MarcosARPMIND/Charger_Power_BOARD_V_0_7_0/PCB/Charger_Power_BOARD_V_0_7_0.kicad_pcb

## KiCad design PCB/Charger_Power_BOARD_V_0_7_0.kicad_pcb (2026-11-06)

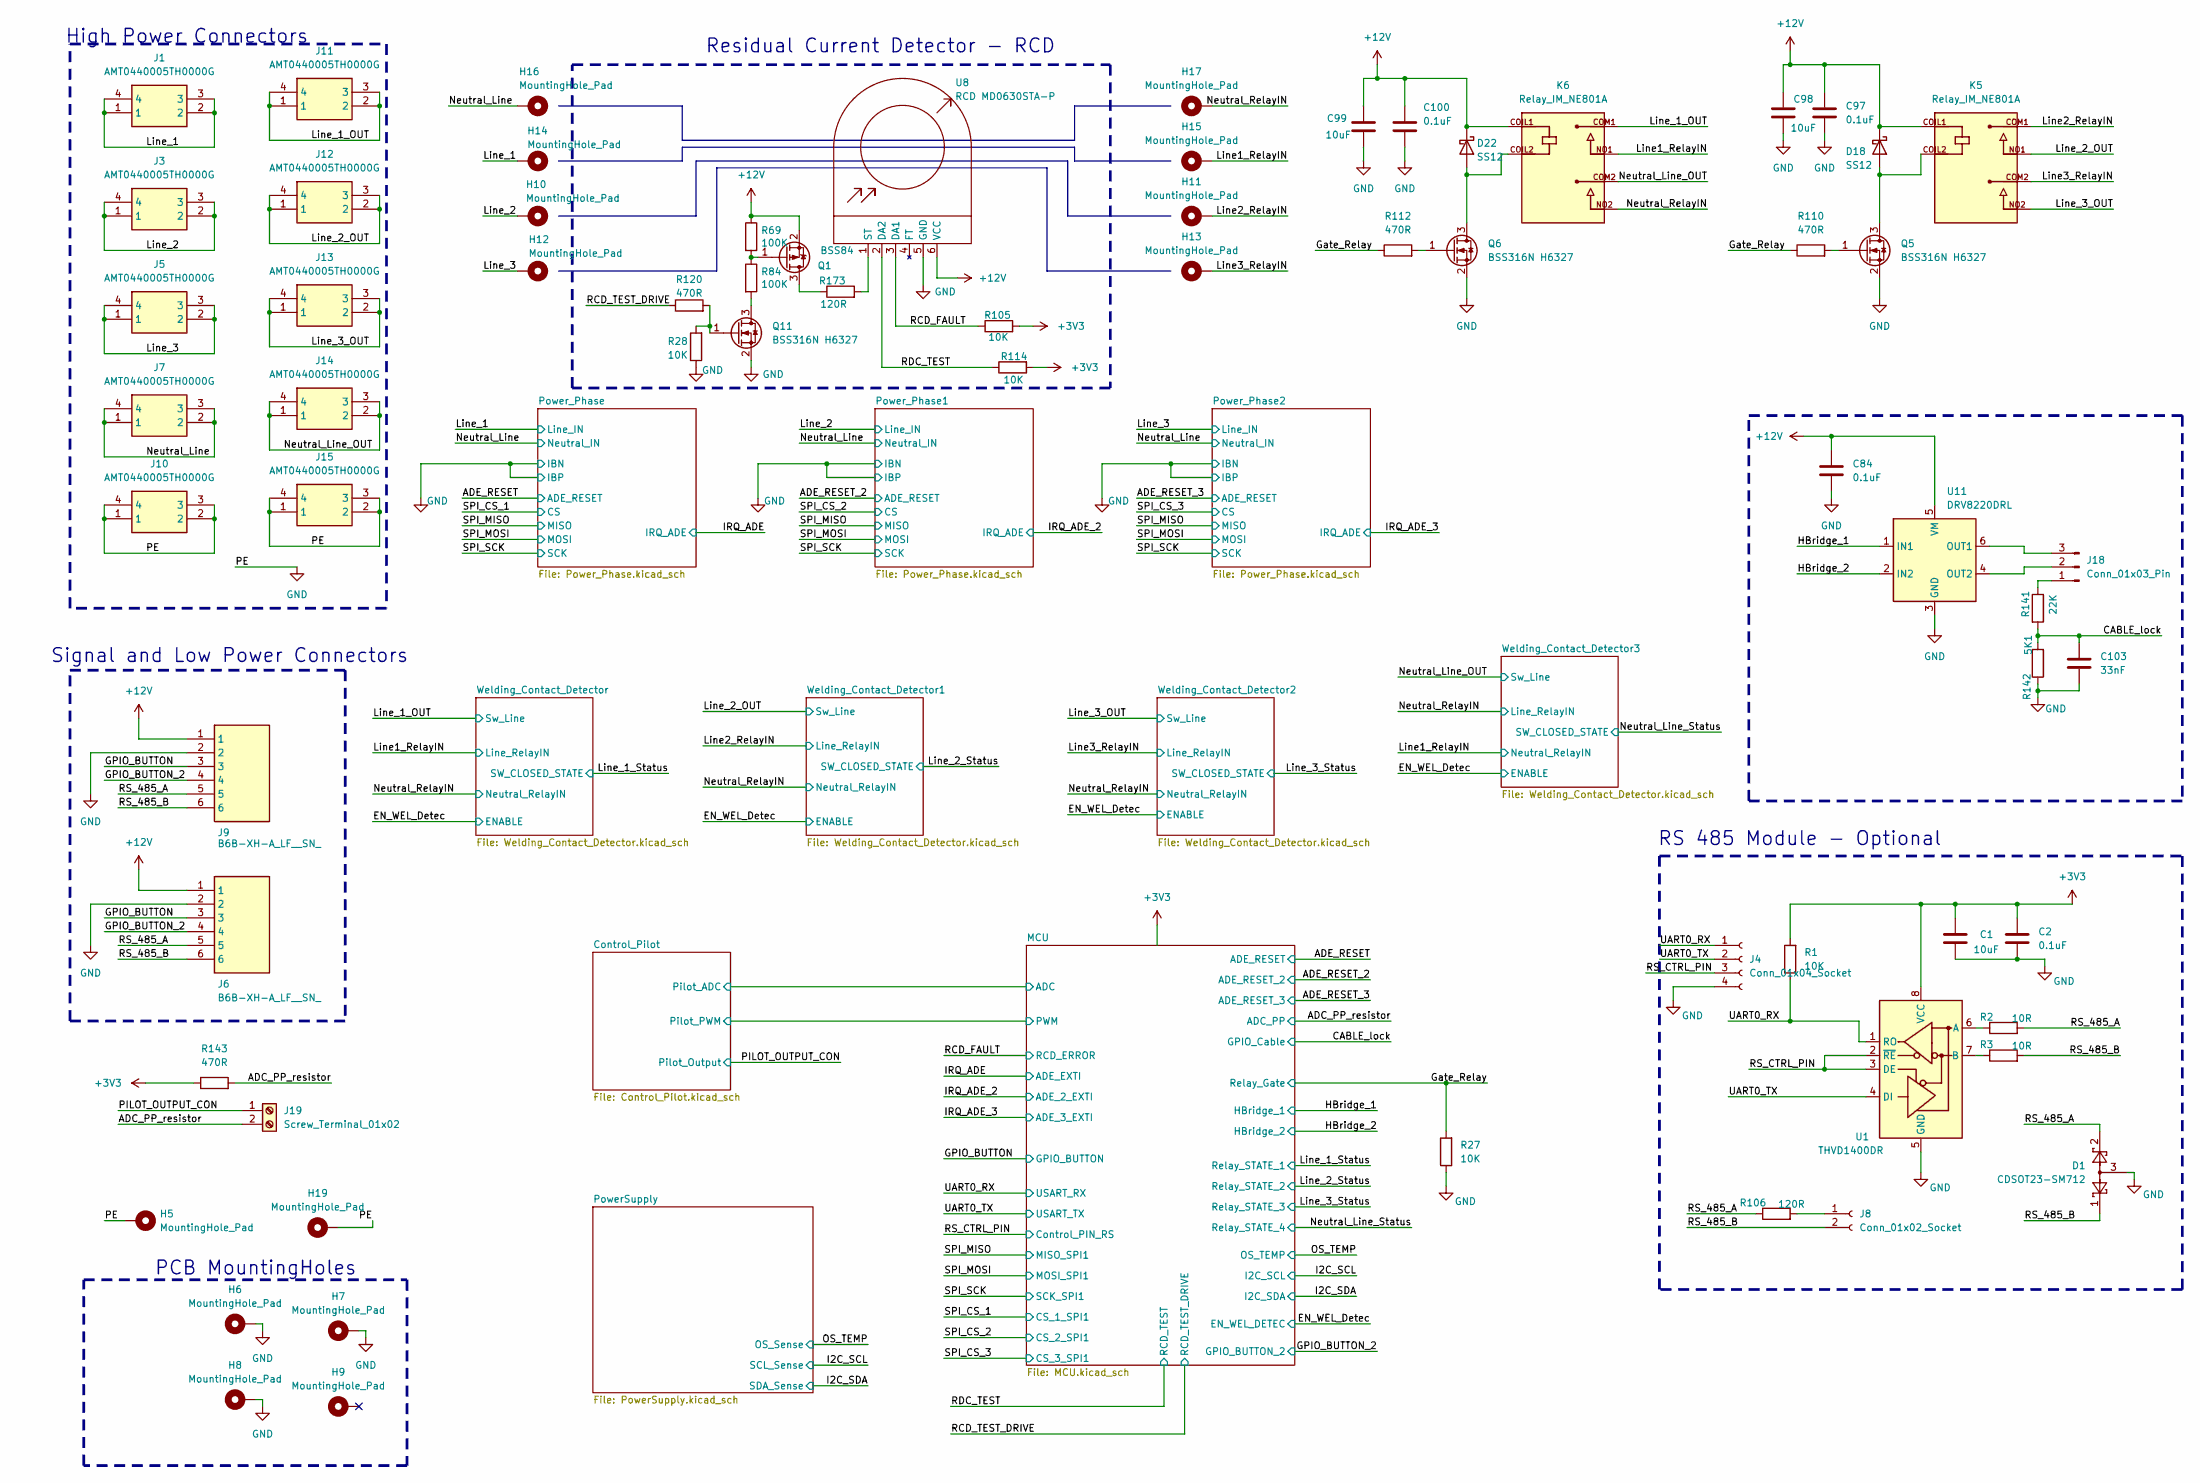
[picture p1: schematic Charger_Power_BOARD_V_0_7_0.kicad_sch]

Parts:
C1: 10uF; C_1206_3216Metric; MPN GMK316AB7106KL-TR
C2, C84, C97, C100: 0.1uF; C_0603_1608Metric; MPN CL10B104MB8NNNC
C98, C99: 10uF; C_1206_3216Metric
C103: 33nF; C_0603_1608Metric
D1: CDSOT23-SM712; SOT-23-3; MPN CDSOT23-SM712
D18, D22: SS12; D_SMA; MPN SS12-E3/61T
H5, H10, H11, H12, H13, H14, H15, H16, H17, H19: MountingHole_Pad; MountingHole_3.2mm_M3_DIN965_Pad_TopBottom
H6, H7, H8: MountingHole_Pad; MountingHole_5.3mm_M5_DIN965_Pad_TopBottom
H9: MountingHole_Pad; MountingHole_5.3mm_M5
J1, J3, J5, J7, J10, J11, J12, J13, J14, J15: AMT0440005TH0000G
J4: Conn_01x04_Socket; PinHeader_1x04_P2.54mm_Vertical
J6, J9: B6B-XH-A_LF__SN_; SHDR6W64P0X250_1X6_1740X575X700P
J8: Conn_01x02_Socket; PinHeader_1x02_P2.54mm_Vertical
J18: Conn_01x03_Pin; JST_VH_B3P-VH-FB-B_1x03_P3.96mm_Vertical
J19: Screw_Terminal_01x02; TerminalBlock_Phoenix_MKDS-3-2-5.08_1x02_P5.08mm_Horizontal
K5, K6: Relay_IM_NE801A
Q1: BSS84; SOT-23
Q5, Q6, Q11: BSS316N H6327; SOT-23; MPN BSS316N H6327
R1, R27, R28, R105, R114: 10K; R_0603_1608Metric; MPN RCS060310K0FKEA
R2, R3: 10R; R_0603_1608Metric; MPN 0603WAF100JT1E
R69, R84: 100K; R_0603_1608Metric
R106: 120R; R_0603_1608Metric; MPN CRCW0603120RFKEAC
R110, R112, R120, R143: 470R; R_0603_1608Metric
R141: 22K; R_0603_1608Metric
R142: 5K1; R_0603_1608Metric
R173: 120R; R_0603_1608Metric; MPN RE0603FRE07150RL
U1: THVD1400DR; SOIC127P600X175-8N
U8: RCD MD0630STA-P; RCD_MD0630STA_P
U11: DRV8220DRL; SOT-563

Connections:
+3V3: C1.2, C2.1, R1.2, R105.2, R114.2, R143.1, U1.8 (VCC); also elsewhere on the board
+12V: C84.1, C97.1, C98.1, C99.1, C100.1, D18.1 (K), D22.1 (K), J6.1, J9.1, K5.COIL1, K6.COIL1, Q1.2 (S), R69.1, U8.6 (VCC), U11.5 (VM); also elsewhere on the board
/ADC_PP_resistor: J19.2, R143.2; also elsewhere on the board
/CABLE_lock: C103.1, R141.2, R142.2; also elsewhere on the board
/GPIO_BUTTON: J6.3, J9.3; also elsewhere on the board
/GPIO_BUTTON_2: J6.4, J9.4; also elsewhere on the board
/Gate_Relay: R27.2, R110.1, R112.1; also elsewhere on the board
/HBridge_1: U11.1 (IN1); also elsewhere on the board
/HBridge_2: U11.2 (IN2); also elsewhere on the board
/Line1_RelayIN: H15.1 (1_1), K6.NO1; also elsewhere on the board
/Line2_RelayIN: H11.1 (1_1), K5.COM1; also elsewhere on the board
/Line3_RelayIN: H13.1 (1_1), K5.COM2; also elsewhere on the board
/Line_1: H14.1 (1_1), J1.1, J1.2, J1.3, J1.4; also elsewhere on the board
/Line_1_OUT: J11.1, J11.2, J11.3, J11.4, K6.COM1; also elsewhere on the board
/Line_2: H10.1 (1_1), J3.1, J3.2, J3.3, J3.4; also elsewhere on the board
/Line_2_OUT: J12.1, J12.2, J12.3, J12.4, K5.NO1; also elsewhere on the board
/Line_3: H12.1 (1_1), J5.1, J5.2, J5.3, J5.4; also elsewhere on the board
/Line_3_OUT: J13.1, J13.2, J13.3, J13.4, K5.NO2; also elsewhere on the board
/Neutral_Line: H16.1 (1_1), J7.1, J7.2, J7.3, J7.4; also elsewhere on the board
/Neutral_Line_OUT: J14.1, J14.2, J14.3, J14.4, K6.COM2; also elsewhere on the board
/Neutral_RelayIN: H17.1 (1_1), K6.NO2; also elsewhere on the board
/PILOT_OUTPUT_CON: J19.1; also elsewhere on the board
/RCD_FAULT: R105.1, U8.3 (DA1); also elsewhere on the board
/RCD_TEST_DRIVE: R120.1; also elsewhere on the board
/RDC_TEST: R114.1, U8.2 (DA2); also elsewhere on the board
/RS_485_A: D1.2, J6.5, J9.5, R2.2, R106.1
/RS_485_B: D1.1, J6.6, J8.2, J9.6, R3.2
/RS_CTRL_PIN: J4.3, U1.2 (~RE), U1.3 (DE); also elsewhere on the board
/UART0_RX: J4.1, R1.1, U1.1 (RO); also elsewhere on the board
/UART0_TX: J4.2, U1.4 (DI); also elsewhere on the board
GND: C1.1, C2.2, C84.2, C97.2, C98.2, C99.2, C100.2, C103.2, D1.3, H5.1 (1_1), H6.1 (1_1), H7.1 (1_1), H8.1 (1_1), H19.1 (1_1), J4.4, J6.2, J9.2, J10.1, J10.2, J10.3, J10.4, J15.1, J15.2, J15.3, J15.4, Q5.2 (S), Q6.2 (S), Q11.2 (S), R27.1, R28.1, R142.1, U1.5 (GND), U8.5 (GND), U11.3 (GND); also elsewhere on the board
unnamed: D18.2 (A), K5.COIL2, Q5.3 (D)
unnamed: D22.2 (A), K6.COIL2, Q6.3 (D)
unnamed: J8.1, R106.2
unnamed: J18.1, R141.1
unnamed: J18.2, U11.4 (OUT2)
unnamed: J18.3, U11.6 (OUT1)
unnamed: Q1.3 (D), R173.1
unnamed: Q1.1 (G), R69.2, R84.1
unnamed: Q5.1 (G), R110.2
unnamed: Q6.1 (G), R112.2
unnamed: Q11.3 (D), R84.2
unnamed: Q11.1 (G), R28.2, R120.2
unnamed: R2.1, U1.6 (A)
unnamed: R3.1, U1.7 (B)
unnamed: R173.2, U8.1 (ST)

Notes on the sheet:
PCB MountingHoles
Residual Current Detector - RCD
RS 485 Module - Optional
Signal and Low Power Connectors
High Power Connectors

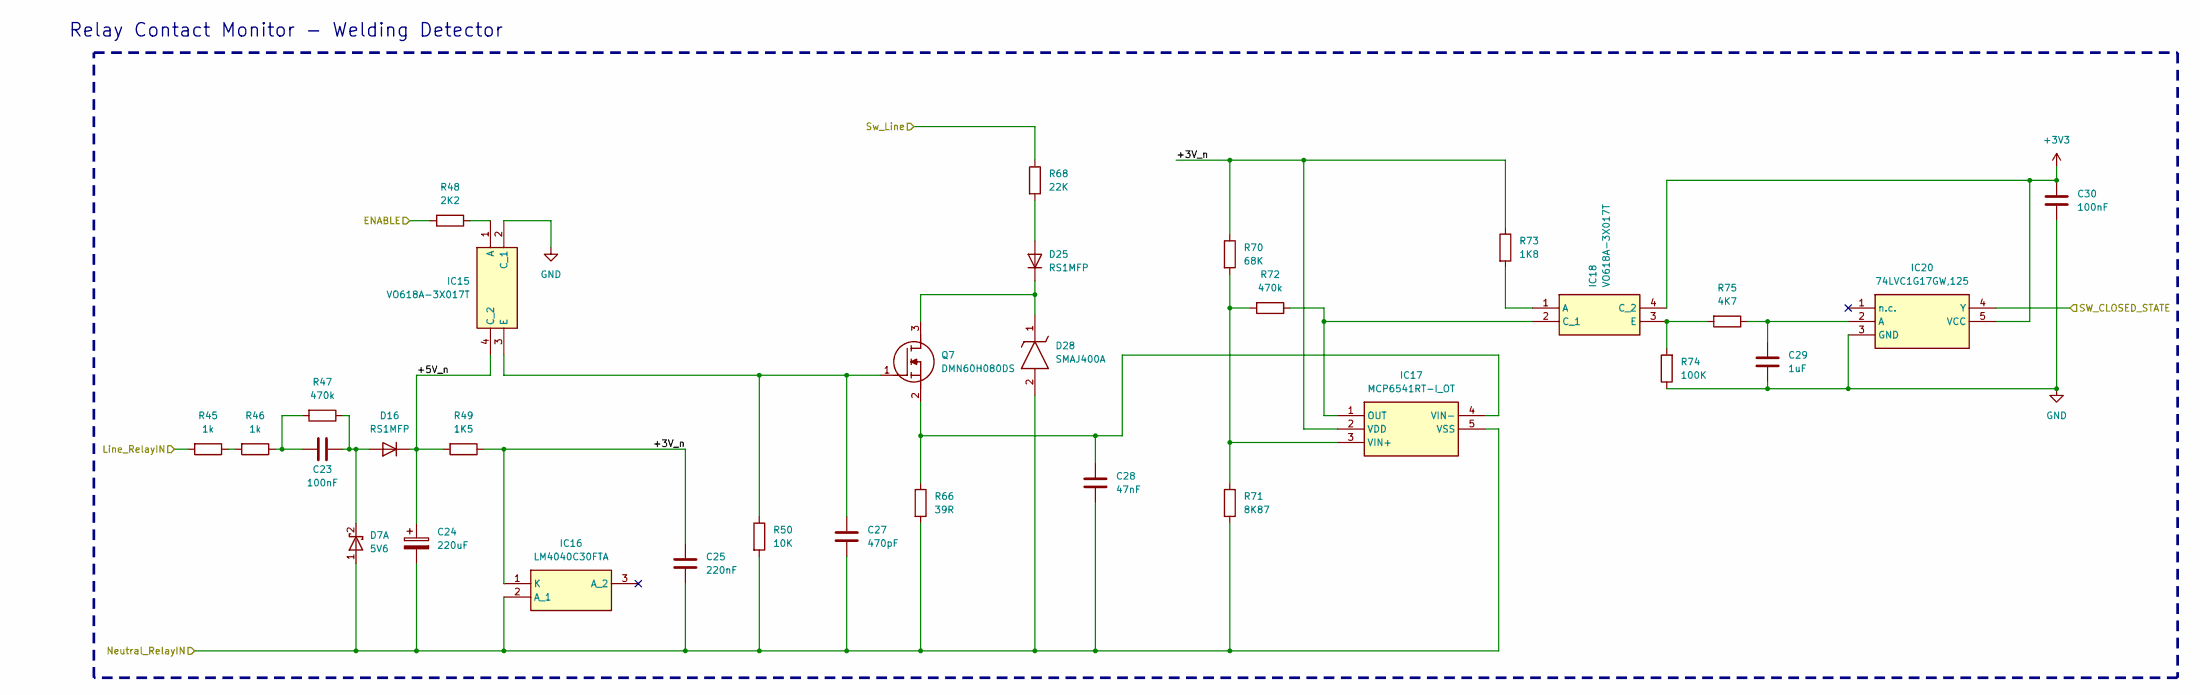
[picture p2: schematic Welding_Contact_Detector.kicad_sch]

Parts:
C23: 100nF; C_Rect_L18.0mm_W5.0mm_P15.00mm_FKS3_FKP3
C24: 220uF; CP_Radial_D8.0mm_P3.50mm
C25: 220nF; C_0603_1608Metric
C27: 470pF; C_0603_1608Metric
C28: 47nF; C_0603_1608Metric
C29: 1uF; C_0603_1608Metric
C30: 100nF; C_0603_1608Metric
D7: 5V6; D_SOD-123
D16, D25: RS1MFP; D_SOD-123
D28: SMAJ400A; DIOM5026X229N
IC15, IC18: VO618A-3X017T; SMD-4_OPTION_7
IC16: LM4040C30FTA; SOT-23-3
IC17: MCP6541RT-I_OT; SOT95P280X145-5N
IC20: 74LVC1G17GW,125; SOT65P212X110-5N
Q7: DMN60H080DS; SOT-23-3
R45, R46: 1k; R_1206_3216Metric
R47: 470k; R_1206_3216Metric
R48: 2K2; R_0603_1608Metric
R49: 1K5; R_0603_1608Metric
R50: 10K; R_0603_1608Metric
R66: 39R; R_0603_1608Metric
R68: 22K; R_Axial_DIN0411_L9.9mm_D3.6mm_P12.70mm_Horizontal
R70: 68K; R_0603_1608Metric
R71: 8K87; R_0603_1608Metric
R72: 470k; R_0603_1608Metric
R73: 1K8; R_0603_1608Metric
R74: 100K; R_0603_1608Metric
R75: 4K7; R_0603_1608Metric

Connections:
+3V3: C30.1, IC18.4 (C_2), IC20.5 (VCC); also elsewhere on the board
/EN_WEL_Detec: R48.2; also elsewhere on the board
/Line2_RelayIN: R45.2; also elsewhere on the board
/Line_2_OUT: R68.1; also elsewhere on the board
/Line_2_Status: IC20.4 (Y); also elsewhere on the board
/Neutral_RelayIN: C24.2, C25.2, C27.2, C28.2, D7.1 (A), D28.2 (A), IC16.2 (A_1), IC17.5 (VSS), R50.2, R66.2, R71.2; also elsewhere on the board
/Welding_Contact_Detector1/+3V_n: C25.1, IC16.1 (K), IC17.2 (VDD), R49.1, R70.1, R73.1
/Welding_Contact_Detector1/+5V_n: C24.1, D16.1 (K), IC15.4 (C_2), R49.2
GND: C29.2, C30.2, IC15.2 (C_1), IC20.3 (GND), R74.1; also elsewhere on the board
unnamed: C23.2, R46.1, R47.2
unnamed: C23.1, D7.2 (K), D16.2 (A), R47.1
unnamed: D25.2 (A), R68.2
unnamed: D25.1 (K), D28.1 (K), Q7.3 (D)
unnamed: IC15.1 (A), R48.1
unnamed: C27.1, IC15.3 (E), Q7.1 (G), R50.1
unnamed: IC17.1 (OUT), IC18.2 (C_1), R72.1
unnamed: IC17.3 (VIN+), R70.2, R71.1, R72.2
unnamed: C28.1, IC17.4 (VIN-), Q7.2 (S), R66.1
unnamed: IC18.1 (A), R73.2
unnamed: IC18.3 (E), R74.2, R75.2
unnamed: C29.1, IC20.2 (A), R75.1
unnamed: R45.1, R46.2

Parts of its further copies:
C26, C37, C61: 100nF; C_Rect_L18.0mm_W5.0mm_P15.00mm_FKS3_FKP3
C31, C38, C62: 220uF; CP_Radial_D8.0mm_P3.50mm
C32, C39, C63: 220nF; C_0603_1608Metric
C33, C40, C64: 470pF; C_0603_1608Metric
C34, C58, C65: 47nF; C_0603_1608Metric
C35, C59, C66: 1uF; C_0603_1608Metric
C36, C60, C67: 100nF; C_0603_1608Metric
D29, D49, D53: 5V6; D_SOD-123
D30, D31, D50, D51, D54, D55: RS1MFP; D_SOD-123
D48, D52, D56: SMAJ400A; DIOM5026X229N
IC21, IC24, IC26, IC46, IC48, IC51: VO618A-3X017T; SMD-4_OPTION_7
IC22, IC27, IC49: LM4040C30FTA; SOT-23-3
IC23, IC45, IC50: MCP6541RT-I_OT; SOT95P280X145-5N
IC25, IC47, IC52: 74LVC1G17GW,125; SOT65P212X110-5N
Q8, Q9, Q10: DMN60H080DS; SOT-23-3
R76, R77, R91, R92, R127, R128: 1k; R_1206_3216Metric
R78, R93, R129: 470k; R_1206_3216Metric
R79, R115, R130: 2K2; R_0603_1608Metric
R80, R116, R131: 1K5; R_0603_1608Metric
R81, R117, R132: 10K; R_0603_1608Metric
R82, R118, R133: 39R; R_0603_1608Metric
R83, R119, R134: 22K; R_Axial_DIN0411_L9.9mm_D3.6mm_P12.70mm_Horizontal
R85, R121, R136: 68K; R_0603_1608Metric
R86, R122, R137: 8K87; R_0603_1608Metric
R87, R123, R138: 470k; R_0603_1608Metric
R88, R124, R139: 1K8; R_0603_1608Metric
R89, R125, R140: 100K; R_0603_1608Metric
R90, R126, R215: 4K7; R_0603_1608Metric

Connections of its further copies:
+3V3: C36.1, C60.1, C67.1, IC24.4 (C_2), IC25.5 (VCC), IC46.4 (C_2), IC47.5 (VCC), IC51.4 (C_2), IC52.5 (VCC); also elsewhere on the board
/EN_WEL_Detec: R79.2, R115.2, R130.2; also elsewhere on the board
/Line1_RelayIN: C62.2, C63.2, C64.2, C65.2, D53.1 (A), D56.2 (A), IC49.2 (A_1), IC50.5 (VSS), R91.2, R132.2, R133.2, R137.2; also elsewhere on the board
/Line3_RelayIN: R76.2; also elsewhere on the board
/Line_1_OUT: R119.1; also elsewhere on the board
/Line_1_Status: IC47.4 (Y); also elsewhere on the board
/Line_3_OUT: R83.1; also elsewhere on the board
/Line_3_Status: IC25.4 (Y); also elsewhere on the board
/Neutral_Line_OUT: R134.1; also elsewhere on the board
/Neutral_Line_Status: IC52.4 (Y); also elsewhere on the board
/Neutral_RelayIN: C31.2, C32.2, C33.2, C34.2, C38.2, C39.2, C40.2, C58.2, D29.1 (A), D48.2 (A), D49.1 (A), D52.2 (A), IC22.2 (A_1), IC23.5 (VSS), IC27.2 (A_1), IC45.5 (VSS), R81.2, R82.2, R86.2, R117.2, R118.2, R122.2, R127.2; also elsewhere on the board
/Welding_Contact_Detector2/+3V_n: C32.1, IC22.1 (K), IC23.2 (VDD), R80.1, R85.1, R88.1
/Welding_Contact_Detector2/+5V_n: C31.1, D30.1 (K), IC21.4 (C_2), R80.2
/Welding_Contact_Detector3/+3V_n: C63.1, IC49.1 (K), IC50.2 (VDD), R131.1, R136.1, R139.1
/Welding_Contact_Detector3/+5V_n: C62.1, D54.1 (K), IC48.4 (C_2), R131.2
/Welding_Contact_Detector/+3V_n: C39.1, IC27.1 (K), IC45.2 (VDD), R116.1, R121.1, R124.1
/Welding_Contact_Detector/+5V_n: C38.1, D50.1 (K), IC26.4 (C_2), R116.2
GND: C35.2, C36.2, C59.2, C60.2, C66.2, C67.2, IC21.2 (C_1), IC25.3 (GND), IC26.2 (C_1), IC47.3 (GND), IC48.2 (C_1), IC52.3 (GND), R89.1, R125.1, R140.1; also elsewhere on the board
unnamed: C26.2, R77.1, R78.2
unnamed: C37.2, R92.1, R93.2
unnamed: C61.2, R128.1, R129.2
unnamed: C26.1, D29.2 (K), D30.2 (A), R78.1
unnamed: D31.2 (A), R83.2
unnamed: D31.1 (K), D48.1 (K), Q8.3 (D)
unnamed: C37.1, D49.2 (K), D50.2 (A), R93.1
unnamed: D51.2 (A), R119.2
unnamed: D51.1 (K), D52.1 (K), Q9.3 (D)
unnamed: C61.1, D53.2 (K), D54.2 (A), R129.1
unnamed: D55.2 (A), R134.2
unnamed: D55.1 (K), D56.1 (K), Q10.3 (D)
unnamed: IC21.1 (A), R79.1
unnamed: C33.1, IC21.3 (E), Q8.1 (G), R81.1
unnamed: IC23.1 (OUT), IC24.2 (C_1), R87.1
unnamed: IC23.3 (VIN+), R85.2, R86.1, R87.2
unnamed: C34.1, IC23.4 (VIN-), Q8.2 (S), R82.1
unnamed: IC24.1 (A), R88.2
unnamed: IC24.3 (E), R89.2, R90.2
unnamed: C35.1, IC25.2 (A), R90.1
unnamed: IC26.1 (A), R115.1
unnamed: C40.1, IC26.3 (E), Q9.1 (G), R117.1
unnamed: IC45.1 (OUT), IC46.2 (C_1), R123.1
unnamed: IC45.3 (VIN+), R121.2, R122.1, R123.2
unnamed: C58.1, IC45.4 (VIN-), Q9.2 (S), R118.1
unnamed: IC46.1 (A), R124.2
unnamed: IC46.3 (E), R125.2, R126.2
unnamed: C59.1, IC47.2 (A), R126.1
unnamed: IC48.1 (A), R130.1
unnamed: C64.1, IC48.3 (E), Q10.1 (G), R132.1
unnamed: IC50.1 (OUT), IC51.2 (C_1), R138.1
unnamed: IC50.3 (VIN+), R136.2, R137.1, R138.2
unnamed: C65.1, IC50.4 (VIN-), Q10.2 (S), R133.1
unnamed: IC51.1 (A), R139.2
unnamed: IC51.3 (E), R140.2, R215.2
unnamed: C66.1, IC52.2 (A), R215.1
unnamed: R76.1, R77.2
unnamed: R91.1, R92.2
unnamed: R127.1, R128.2

Notes on the sheet:
Relay Contact Monitor - Welding Detector

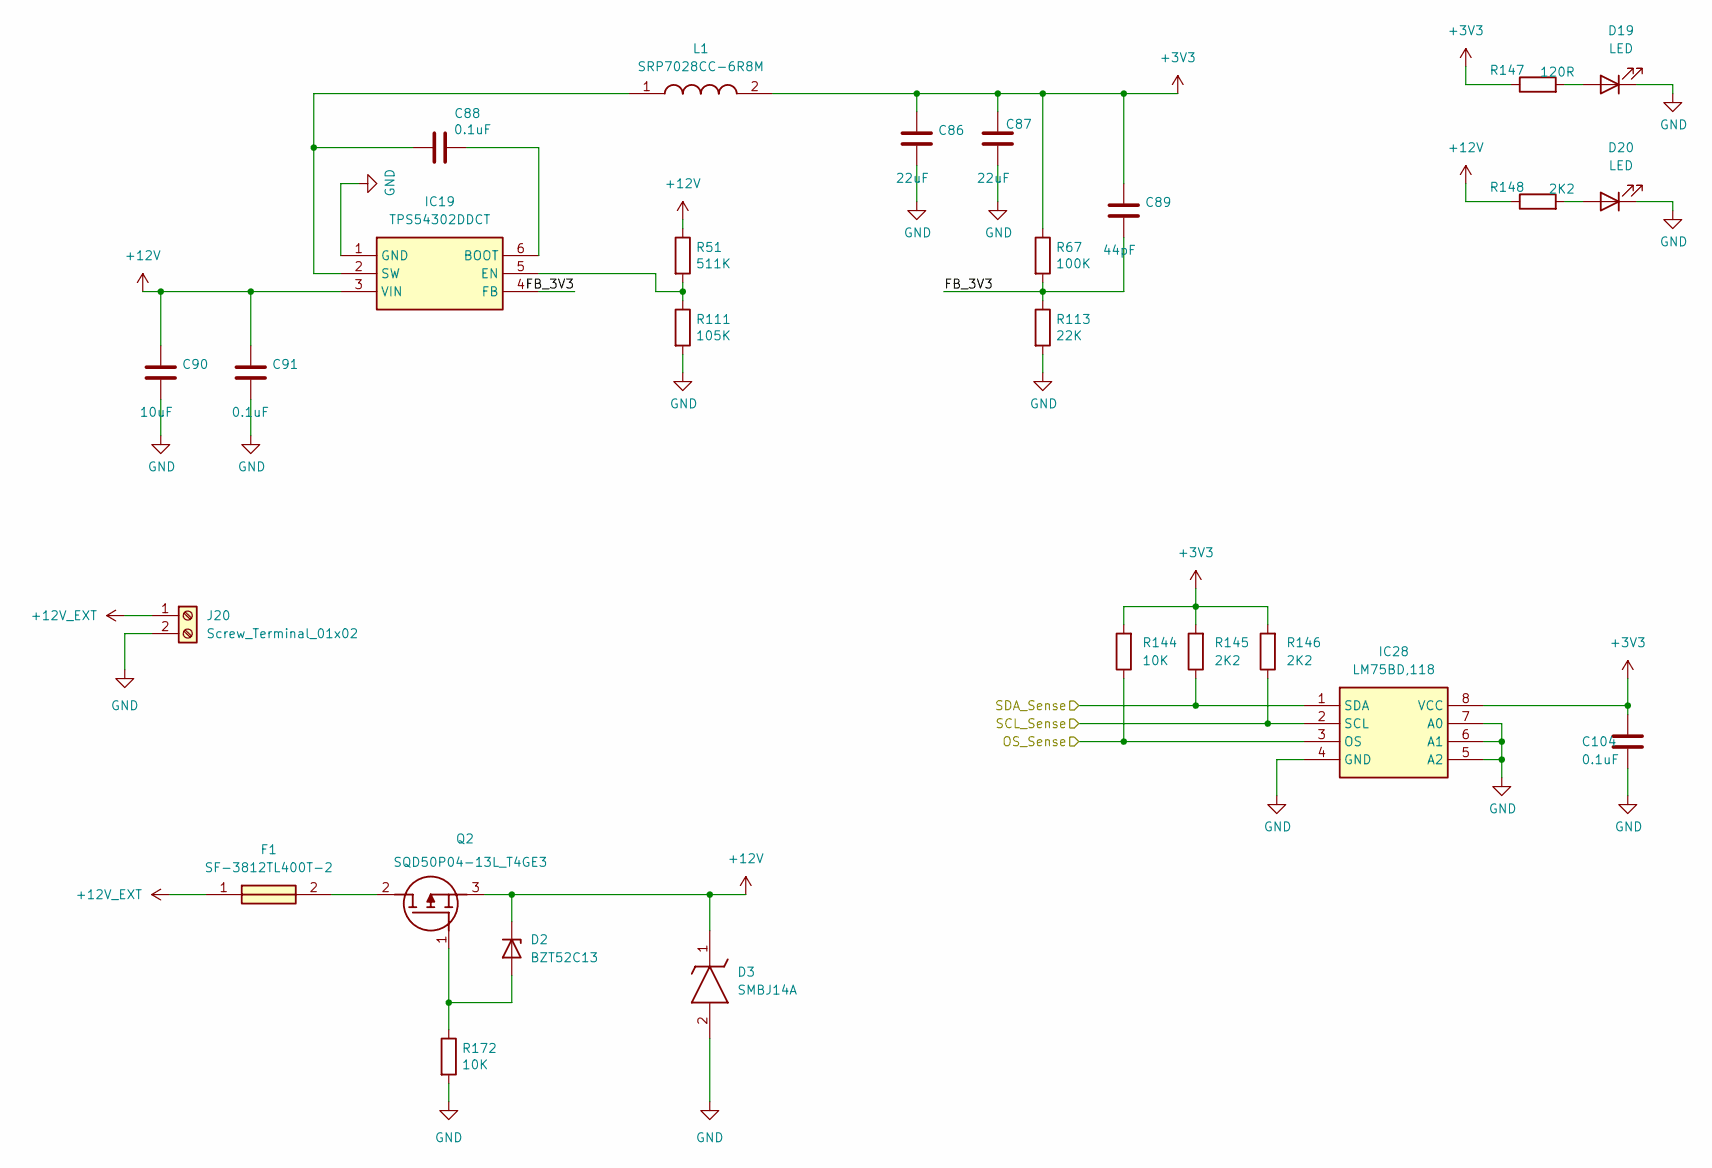
[picture p3: schematic PowerSupply.kicad_sch]

Parts:
C86, C87: 22uF; C_1206_3216Metric
C88, C91: 0.1uF; C_0603_1608Metric
C89: 44pF; C_0603_1608Metric
C90: 10uF; C_1206_3216Metric
C104: 0.1uF; C_0603_1608Metric; MPN CL10B104MB8NNNC
D2: BZT52C13; D_SOD-123
D3: SMBJ14A; DIOM5436X261N; Manufacturer_Part_Number SMBJ14A
D19, D20: LED; LED_0603_1608Metric
F1: SF-3812TL400T-2; SF3812TL400T2; Mouser Part Number 652-SF-3812TL400T-2
IC19: TPS54302DDCT; SOT95P280X110-6N
IC28: LM75BD,118; SOIC127P600X175-8N
J20: Screw_Terminal_01x02; TerminalBlock_Phoenix_MKDS-3-2-5.08_1x02_P5.08mm_Horizontal
L1: SRP7028CC-6R8M; INDPM7366X300N
Q2: SQD50P04-13L_T4GE3; SQD50P0413L_T4GE3; Mouser Part Number 78-SQD50P04-13LT4GE3
R51: 511K; R_0603_1608Metric
R67: 100K; R_0603_1608Metric
R111: 105K; R_0603_1608Metric
R113: 22K; R_0603_1608Metric
R144, R172: 10K; R_0603_1608Metric; MPN RCS060310K0FKEA
R145, R146: 2K2; R_0603_1608Metric; MPN RCS060310K0FKEA
R147: 120R; R_0603_1608Metric; MPN CRCW0603120RFKEAC
R148: 2K2; R_0603_1608Metric; MPN AC0603FR-072K2L

Connections:
+3V3: C86.1, C87.1, C89.1, C104.1, IC28.8 (VCC), L1.2, R67.1, R144.2, R145.2, R146.2, R147.1; also elsewhere on the board
+12V: C90.1, C91.1, D2.1 (K), D3.1 (K), IC19.3 (VIN), Q2.3 (S), R51.1, R148.1; also elsewhere on the board
+12V_EXT: F1.1, J20.1
/I2C_SCL: IC28.2 (SCL), R146.1; also elsewhere on the board
/I2C_SDA: IC28.1 (SDA), R145.1; also elsewhere on the board
/OS_TEMP: IC28.3 (OS), R144.1; also elsewhere on the board
/PowerSupply/FB_3V3: C89.2, IC19.4 (FB), R67.2, R113.1
GND: C86.2, C87.2, C90.2, C91.2, C104.2, D3.2 (A), D19.1 (K), D20.1 (K), IC19.1 (GND), IC28.4 (GND), IC28.5 (A2), IC28.6 (A1), IC28.7 (A0), J20.2, R111.2, R113.2, R172.2; also elsewhere on the board
unnamed: D2.2 (A), Q2.1 (G), R172.1
unnamed: D19.2 (A), R147.2
unnamed: D20.2 (A), R148.2
unnamed: C88.2, IC19.6 (BOOT)
unnamed: IC19.5 (EN), R51.2, R111.1
unnamed: C88.1, IC19.2 (SW), L1.1
unnamed: F1.2, Q2.2 (D)

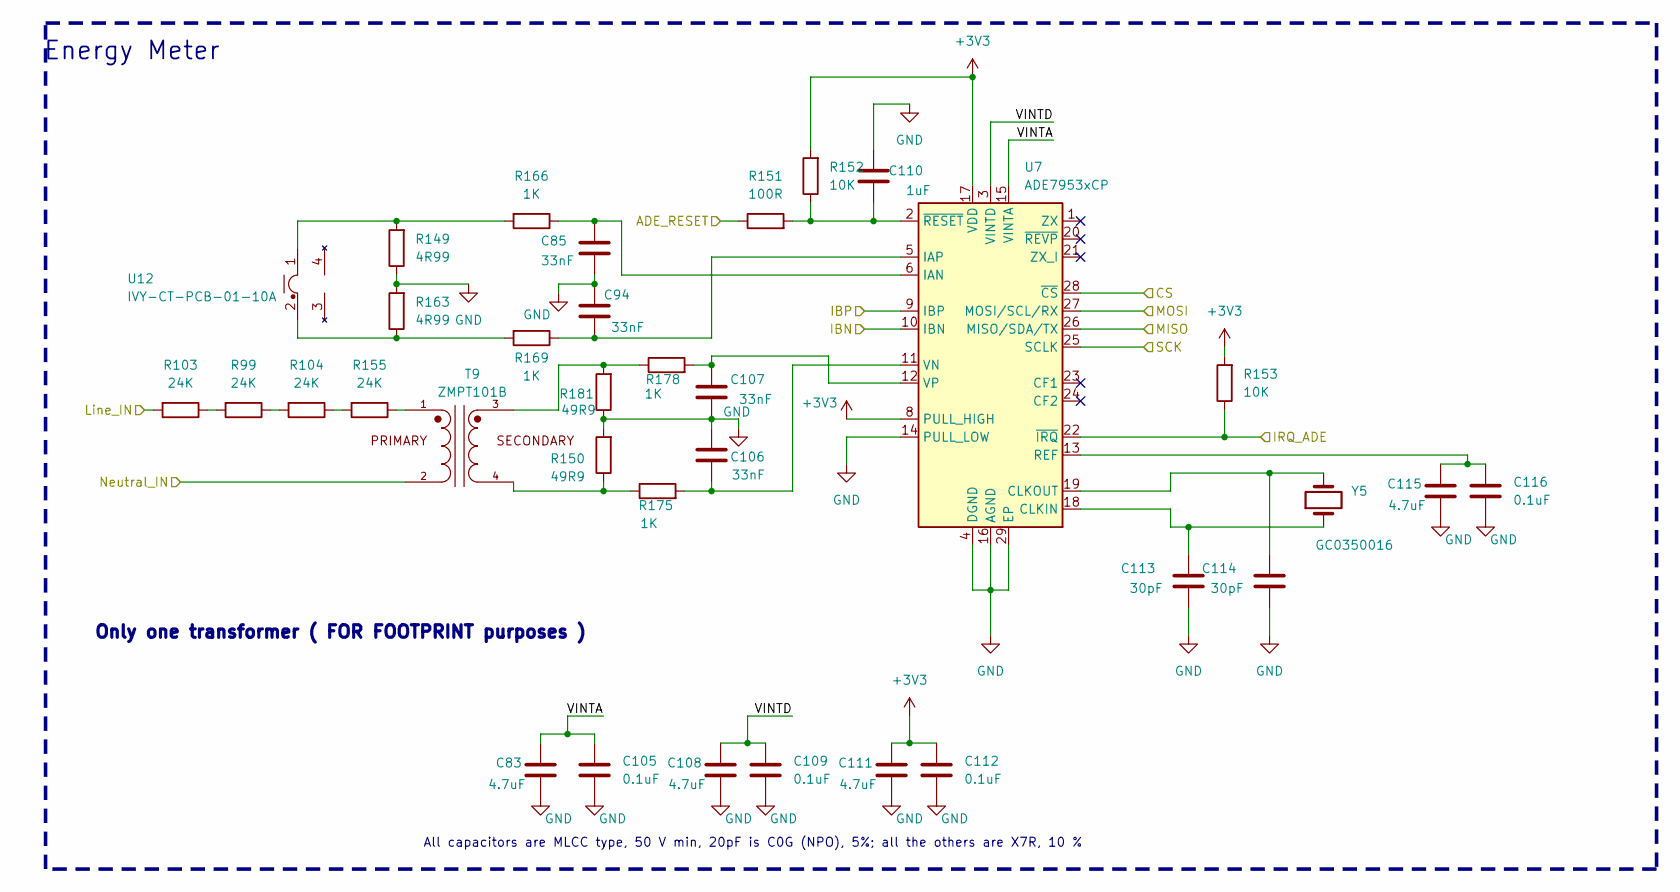
[picture p4: schematic Power_Phase.kicad_sch]

Parts:
C83, C108, C111, C115: 4.7uF; C_0805_2012Metric; MPN GRM21BZ7YA475ME15L
C85, C94, C106, C107: 33nF; C_0603_1608Metric_Pad1.08x0.95mm_HandSolder; MPN 0603B333J500CT
C105, C109, C112, C116: 0.1uF; C_0603_1608Metric; MPN CL10B104MB8NNNC
C110: 1uF; C_1206_3216Metric; MPN CL10B105KB8NQNC
C113, C114: 30pF; C_0603_1608Metric_Pad1.08x0.95mm_HandSolder; MPN CML0603C0G300JT50V
R99, R103, R104, R155: 24K; R_1206_3216Metric; MPN ESR18EZPF2402
R149, R163: 4R99; R_0603_1608Metric; MPN CRCW06034K99FKEAC
R150, R181: 49R9; R_0603_1608Metric; MPN CRCW0603100RJNEA
R151: 100R; R_0603_1608Metric; MPN CRCW0603100RJNEA
R152, R153: 10K; R_0603_1608Metric; MPN RCS060310K0FKEA
R166, R169, R175, R178: 1K; R_0603_1608Metric; MPN CRCW060336R0FKEA
T9: ZMPT101B; XFMR_ZMPT101B
U7: ADE7953xCP; LFCSP-28-1EP_5x5mm_P0.5mm_EP3.14x3.14mm_ThermalVias_MigCOM; MPN ADE7953ACPZ
U12: IVY-CT-PCB-01-10A; CT_IVY_01_10A
Y5: GC0350016; Crystal_SMD_HC49-SD; MPN GC0350016

Connections:
+3V3: C111.2, C112.1, R152.2, R153.2, U7.7 (PULL_HIGH), U7.8 (PULL_HIGH), U7.17 (VDD); also elsewhere on the board
/ADE_RESET_2: R151.1; also elsewhere on the board
/IRQ_ADE_2: R153.1, U7.22 (~IRQ); also elsewhere on the board
/Line_2: R103.2; also elsewhere on the board
/Neutral_Line: T9.2; also elsewhere on the board
/Power_Phase1/VINTA: C83.2, C105.1, U7.15 (VINTA)
/Power_Phase1/VINTD: C108.2, C109.1, U7.3 (VINTD)
/SPI_CS_2: U7.28 (~CS); also elsewhere on the board
/SPI_MISO: U7.26 (MISO/SDA/TX); also elsewhere on the board
/SPI_MOSI: U7.27 (MOSI/SCL/RX); also elsewhere on the board
/SPI_SCK: U7.25 (SCLK); also elsewhere on the board
GND: C83.1, C85.1, C94.2, C105.2, C106.2, C107.1, C108.1, C109.2, C110.2, C111.1, C112.2, C113.1, C114.1, C115.1, C116.2, R149.1, R150.2, R163.2, R181.1, U7.4 (DGND), U7.9 (IBP), U7.10 (IBN), U7.14 (PULL_LOW), U7.16 (AGND), U7.29 (EP); also elsewhere on the board
unnamed: R99.2, R103.1
unnamed: R104.1, R155.2
unnamed: R99.1, R104.2
unnamed: R149.2, R166.2, U12.1
unnamed: R150.1, R175.1, T9.4
unnamed: R155.1, T9.1
unnamed: R163.1, R169.2, U12.2
unnamed: R178.1, R181.2, T9.3
unnamed: C113.2, U7.18 (CLKIN), Y5.1
unnamed: C114.2, U7.19 (CLKOUT), Y5.2
unnamed: C85.2, R166.1, U7.6 (IAN)
unnamed: C94.1, R169.1, U7.5 (IAP)
unnamed: C115.2, C116.1, U7.13 (REF)
unnamed: C106.1, R175.2, U7.11 (VN)
unnamed: C107.2, R178.2, U7.12 (VP)
unnamed: C110.1, R151.2, R152.1, U7.2 (~RESET)

Parts of its further copies:
C70, C123: 1uF; C_1206_3216Metric; MPN CL10B105KB8NQNC
C71, C77, C79, C81, C117, C121, C124, C128: 4.7uF; C_0805_2012Metric; MPN GRM21BZ7YA475ME15L
C72, C78, C80, C82, C118, C122, C125, C129: 0.1uF; C_0603_1608Metric; MPN CL10B104MB8NNNC
C73, C74, C92, C93, C95, C96, C119, C120: 33nF; C_0603_1608Metric_Pad1.08x0.95mm_HandSolder; MPN 0603B333J500CT
C75, C76, C126, C127: 30pF; C_0603_1608Metric_Pad1.08x0.95mm_HandSolder; MPN CML0603C0G300JT50V
R94, R97, R161, R162: 10K; R_0603_1608Metric; MPN RCS060310K0FKEA
R95, R160: 100R; R_0603_1608Metric; MPN CRCW0603100RJNEA
R96, R158, R164, R165: 4R99; R_0603_1608Metric; MPN CRCW06034K99FKEAC
R98, R100, R101, R107, R108, R154, R156, R157: 24K; R_1206_3216Metric; MPN ESR18EZPF2402
R102, R159, R182, R183: 49R9; R_0603_1608Metric; MPN CRCW0603100RJNEA
R167, R168, R170, R171, R176, R177, R179, R180: 1K; R_0603_1608Metric; MPN CRCW060336R0FKEA
T7, T11: ZMPT101B; XFMR_ZMPT101B
U6, U9: ADE7953xCP; LFCSP-28-1EP_5x5mm_P0.5mm_EP3.14x3.14mm_ThermalVias_MigCOM; MPN ADE7953ACPZ
U10, U13: IVY-CT-PCB-01-10A; CT_IVY_01_10A
Y4, Y6: GC0350016; Crystal_SMD_HC49-SD; MPN GC0350016

Connections of its further copies:
+3V3: C81.2, C82.1, C124.2, C125.1, R94.2, R97.2, R161.2, R162.2, U6.7 (PULL_HIGH), U6.8 (PULL_HIGH), U6.17 (VDD), U9.7 (PULL_HIGH), U9.8 (PULL_HIGH), U9.17 (VDD); also elsewhere on the board
/ADE_RESET: R95.1; also elsewhere on the board
/ADE_RESET_3: R160.1; also elsewhere on the board
/IRQ_ADE: R97.1, U6.22 (~IRQ); also elsewhere on the board
/IRQ_ADE_3: R162.1, U9.22 (~IRQ); also elsewhere on the board
/Line_1: R98.2; also elsewhere on the board
/Line_3: R154.2; also elsewhere on the board
/Neutral_Line: T7.2, T11.2; also elsewhere on the board
/Power_Phase2/VINTA: C117.2, C118.1, U9.15 (VINTA)
/Power_Phase2/VINTD: C121.2, C122.1, U9.3 (VINTD)
/Power_Phase/VINTA: C77.2, C78.1, U6.15 (VINTA)
/Power_Phase/VINTD: C79.2, C80.1, U6.3 (VINTD)
/SPI_CS_1: U6.28 (~CS); also elsewhere on the board
/SPI_CS_3: U9.28 (~CS); also elsewhere on the board
/SPI_MISO: U6.26 (MISO/SDA/TX), U9.26 (MISO/SDA/TX); also elsewhere on the board
/SPI_MOSI: U6.27 (MOSI/SCL/RX), U9.27 (MOSI/SCL/RX); also elsewhere on the board
/SPI_SCK: U6.25 (SCLK), U9.25 (SCLK); also elsewhere on the board
GND: C70.2, C71.1, C72.2, C73.2, C74.1, C75.1, C76.1, C77.1, C78.2, C79.1, C80.2, C81.1, C82.2, C92.1, C93.1, C95.2, C96.2, C117.1, C118.2, C119.2, C120.1, C121.1, C122.2, C123.2, C124.1, C125.2, C126.1, C127.1, C128.1, C129.2, R96.1, R102.2, R158.1, R159.2, R164.2, R165.2, R182.1, R183.1, U6.4 (DGND), U6.9 (IBP), U6.10 (IBN), U6.14 (PULL_LOW), U6.16 (AGND), U6.29 (EP), U9.4 (DGND), U9.9 (IBP), U9.10 (IBN), U9.14 (PULL_LOW), U9.16 (AGND), U9.29 (EP); also elsewhere on the board
unnamed: R100.1, R107.2
unnamed: R100.2, R154.1
unnamed: R101.1, R108.2
unnamed: R98.1, R101.2
unnamed: R102.1, R177.1, T7.4
unnamed: R107.1, R156.2
unnamed: R108.1, R157.2
unnamed: R156.1, T11.1
unnamed: R157.1, T7.1
unnamed: R158.2, R167.2, U13.1
unnamed: R159.1, R176.1, T11.4
unnamed: R164.1, R170.2, U13.2
unnamed: R165.1, R171.2, U10.2
unnamed: R96.2, R168.2, U10.1
unnamed: R179.1, R182.2, T11.3
unnamed: R180.1, R183.2, T7.3
unnamed: C75.2, U6.18 (CLKIN), Y4.1
unnamed: C76.2, U6.19 (CLKOUT), Y4.2
unnamed: C93.2, R168.1, U6.6 (IAN)
unnamed: C96.1, R171.1, U6.5 (IAP)
unnamed: C71.2, C72.1, U6.13 (REF)
unnamed: C73.1, R177.2, U6.11 (VN)
unnamed: C74.2, R180.2, U6.12 (VP)
unnamed: C70.1, R94.1, R95.2, U6.2 (~RESET)
unnamed: C126.2, U9.18 (CLKIN), Y6.1
unnamed: C127.2, U9.19 (CLKOUT), Y6.2
unnamed: C92.2, R167.1, U9.6 (IAN)
unnamed: C95.1, R170.1, U9.5 (IAP)
unnamed: C128.2, C129.1, U9.13 (REF)
unnamed: C119.1, R176.2, U9.11 (VN)
unnamed: C120.2, R179.2, U9.12 (VP)
unnamed: C123.1, R160.2, R161.1, U9.2 (~RESET)

Notes on the sheet:
All capacitors are MLCC type, 50 V min, 20pF is C0G (NPO), 5%; all the others are X7R, 10 %
Energy Meter
Only one transformer ( FOR FOOTPRINT purposes )
