MarcosARPMIND/Charger_Power_BOARD_V_0_7_0/PCB/Charger_Power_BOARD_V_0_7_0.kicad_pcb

## KiCad design PCB/Charger_Power_BOARD_V_0_7_0.kicad_pcb (continued)

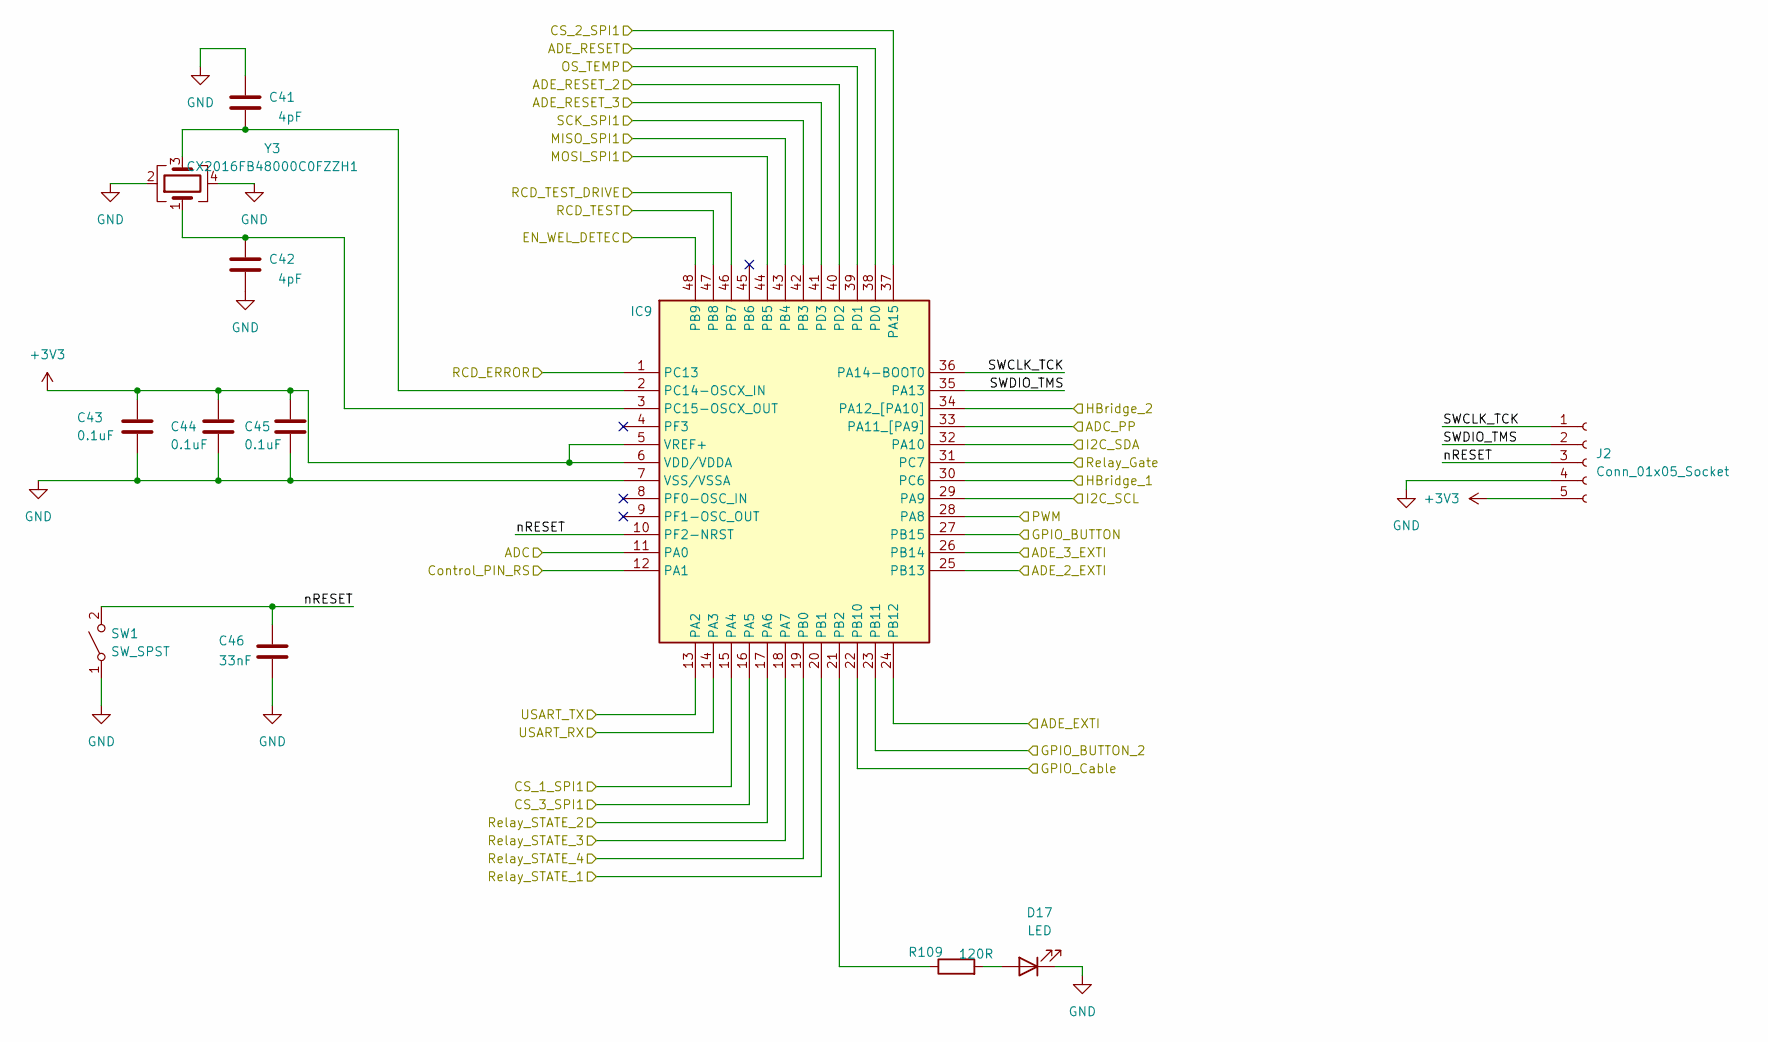
[picture p5: schematic MCU.kicad_sch]

Parts:
C41, C42: 4pF; C_0603_1608Metric_Pad1.08x0.95mm_HandSolder; MPN CC0603BRNPO9BN4R0
C43, C44, C45: 0.1uF; C_0603_1608Metric; MPN CL10B104MB8NNNC
C46: 33nF; C_0603_1608Metric_Pad1.08x0.95mm_HandSolder; MPN 0603B333J500CT
D17: LED; LED_0603_1608Metric
IC9: STM32C031C6T6; QFP50P900X900X160-48N; MPN STM32C031C6T6
J2: Conn_01x05_Socket; PinHeader_1x05_P2.54mm_Vertical
R109: 120R; R_0603_1608Metric; MPN RE0603FRE07150RL
SW1: SW_SPST; SW_SPST_B3U-1000P; MPN B3U-1000PM
Y3: CX2016FB48000C0FZZH1; Crystal_SMD_2016-4Pin_2.0x1.6mm; MPN CX2016FB48000C0FZZH1

Connections:
+3V3: C43.1, C44.1, C45.1, IC9.5 (VREF+), IC9.6 (VDD/VDDA), J2.5; also elsewhere on the board
/ADC_PP_resistor: IC9.33 (PA11_[PA9]); also elsewhere on the board
/ADE_RESET: IC9.38 (PD0); also elsewhere on the board
/ADE_RESET_2: IC9.40 (PD2); also elsewhere on the board
/ADE_RESET_3: IC9.41 (PD3); also elsewhere on the board
/CABLE_lock: IC9.22 (PB10); also elsewhere on the board
/Control_Pilot/Pilot_ADC: IC9.11 (PA0); also elsewhere on the board
/Control_Pilot/Pilot_PWM: IC9.28 (PA8); also elsewhere on the board
/EN_WEL_Detec: IC9.48 (PB9); also elsewhere on the board
/GPIO_BUTTON: IC9.27 (PB15); also elsewhere on the board
/GPIO_BUTTON_2: IC9.23 (PB11); also elsewhere on the board
/Gate_Relay: IC9.31 (PC7); also elsewhere on the board
/HBridge_1: IC9.30 (PC6); also elsewhere on the board
/HBridge_2: IC9.34 (PA12_[PA10]); also elsewhere on the board
/I2C_SCL: IC9.29 (PA9); also elsewhere on the board
/I2C_SDA: IC9.32 (PA10); also elsewhere on the board
/IRQ_ADE: IC9.24 (PB12); also elsewhere on the board
/IRQ_ADE_2: IC9.25 (PB13); also elsewhere on the board
/IRQ_ADE_3: IC9.26 (PB14); also elsewhere on the board
/Line_1_Status: IC9.20 (PB1); also elsewhere on the board
/Line_2_Status: IC9.17 (PA6); also elsewhere on the board
/Line_3_Status: IC9.18 (PA7); also elsewhere on the board
/MCU/SWCLK_TCK: IC9.36 (PA14-BOOT0), J2.1
/MCU/SWDIO_TMS: IC9.35 (PA13), J2.2
/MCU/nRESET: C46.2, IC9.10 (PF2-NRST), J2.3, SW1.2 (B)
/Neutral_Line_Status: IC9.19 (PB0); also elsewhere on the board
/OS_TEMP: IC9.39 (PD1); also elsewhere on the board
/RCD_FAULT: IC9.1 (PC13); also elsewhere on the board
/RCD_TEST_DRIVE: IC9.46 (PB7); also elsewhere on the board
/RDC_TEST: IC9.47 (PB8); also elsewhere on the board
/RS_CTRL_PIN: IC9.12 (PA1); also elsewhere on the board
/SPI_CS_1: IC9.15 (PA4); also elsewhere on the board
/SPI_CS_2: IC9.37 (PA15); also elsewhere on the board
/SPI_CS_3: IC9.16 (PA5); also elsewhere on the board
/SPI_MISO: IC9.43 (PB4); also elsewhere on the board
/SPI_MOSI: IC9.44 (PB5); also elsewhere on the board
/SPI_SCK: IC9.42 (PB3); also elsewhere on the board
/UART0_RX: IC9.14 (PA3); also elsewhere on the board
/UART0_TX: IC9.13 (PA2); also elsewhere on the board
GND: C41.2, C42.1, C43.2, C44.2, C45.2, C46.1, D17.1 (K), IC9.7 (VSS/VSSA), J2.4, SW1.1 (A), Y3.2, Y3.4; also elsewhere on the board
unnamed: D17.2 (A), R109.2
unnamed: IC9.21 (PB2), R109.1
unnamed: C41.1, IC9.2 (PC14-OSCX_IN), Y3.3
unnamed: C42.2, IC9.3 (PC15-OSCX_OUT), Y3.1

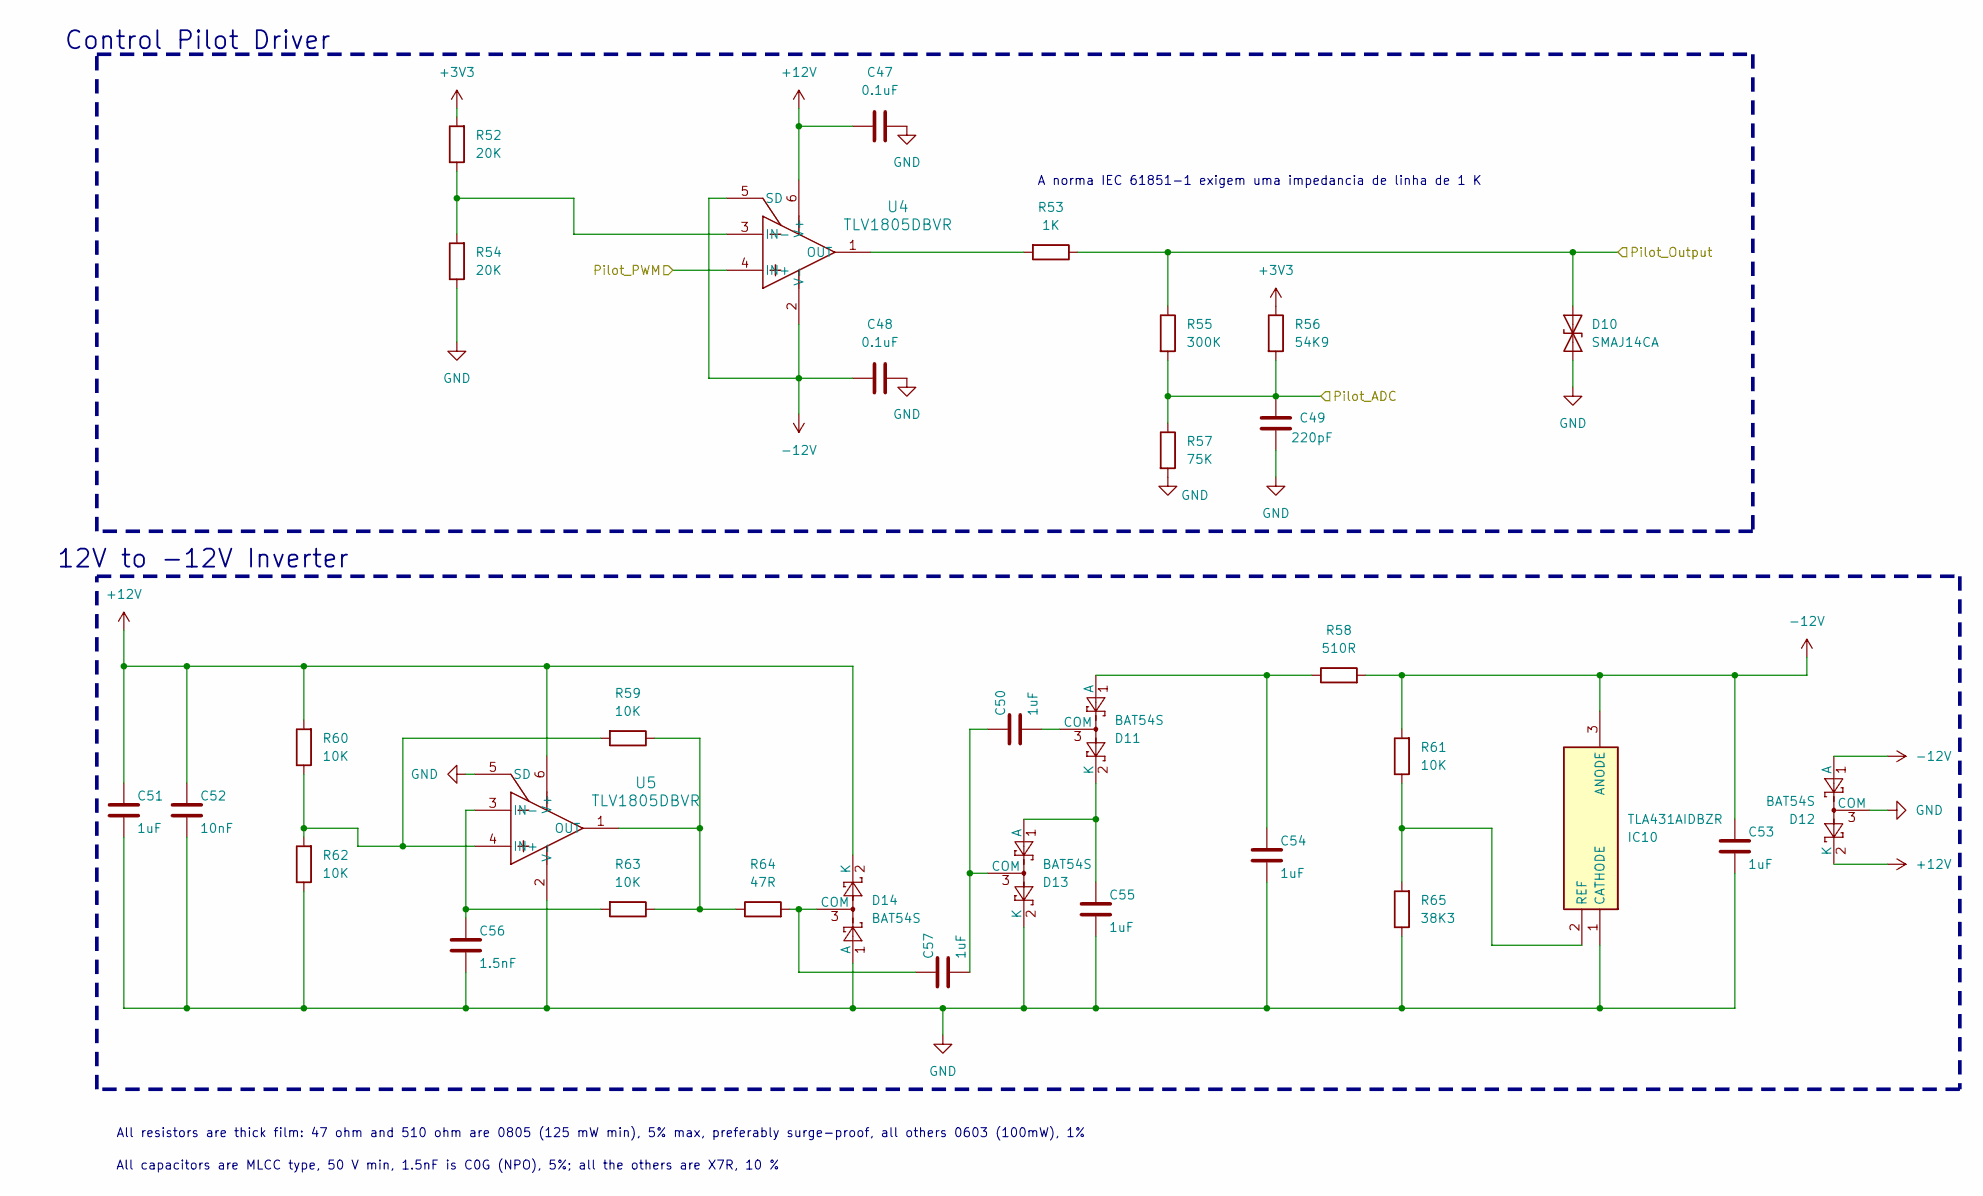
[picture p6: schematic Control_Pilot.kicad_sch]

Parts:
C47, C48: 0.1uF; C_0603_1608Metric; MPN CL10B104MB8NNNC
C49: 220pF; C_0603_1608Metric_Pad1.08x0.95mm_HandSolder; MPN CC0603JRX7R9BB221
C50, C51, C53, C54, C55, C57: 1uF; C_0603_1608Metric_Pad1.08x0.95mm_HandSolder; MPN CL10B105KB8NQNC
C52: 10nF; C_0603_1608Metric_Pad1.08x0.95mm_HandSolder; MPN 06035C103MAZ2A
C56: 1.5nF; C_0603_1608Metric_Pad1.08x0.95mm_HandSolder; MPN GCM1885C1H152JA16J
D10: SMAJ14CA; D_SMA; MPN SMAJ14CA-E3/61
D11, D12, D13, D14: BAT54S; SOT-23; MPN BAT54S-7-F
IC10: TLA431AIDBZR; SOT95P237X112-3N
R52, R54: 20K; R_0603_1608Metric; MPN CRCW060320K0FKEC
R53: 1K; R_1206_3216Metric; MPN CMP1206-FX-1001ELF
R55: 300K; R_0603_1608Metric
R56: 54K9; R_0603_1608Metric; MPN CRCW060354K9FKEA
R57: 75K; R_0603_1608Metric; MPN ERJ-PA3F7502V
R58: 510R; R_0805_2012Metric
R59, R60, R61, R62, R63: 10K; R_0603_1608Metric; MPN RCS060310K0FKEA
R64: 47R; R_0805_2012Metric; MPN CRCW080547R0JNEAC
R65: 38K3; R_0603_1608Metric; MPN CRCW060338K3FKEA
U4, U5: TLV1805DBVR; SOT95P280X145-6N; MPN TLV1805DBVR

Connections:
+3V3: R52.2, R56.1; also elsewhere on the board
+12V: C47.1, C51.1, C52.1, D12.2 (K), D14.2 (K), R60.2, U4.6 (V+), U5.6 (V+); also elsewhere on the board
-12V: C48.1, C53.1, D12.1 (A), IC10.3 (ANODE), R58.2, R61.2, U4.2 (V-), U4.5 (SD)
/Control_Pilot/Pilot_ADC: C49.2, R55.2, R56.2, R57.1; also elsewhere on the board
/Control_Pilot/Pilot_PWM: U4.4 (IN+); also elsewhere on the board
/PILOT_OUTPUT_CON: D10.1 (A1), R53.1, R55.1; also elsewhere on the board
GND: C47.2, C48.2, C49.1, C51.2, C52.2, C53.2, C54.2, C55.2, C56.2, D10.2 (A2), D12.3 (COM), D13.2 (K), D14.1 (A), IC10.1 (CATHODE), R54.1, R57.2, R62.1, R65.1, U5.2 (V-), U5.5 (SD); also elsewhere on the board
unnamed: C54.1, D11.1 (A), R58.1
unnamed: C50.2, D11.3 (COM)
unnamed: C55.1, D11.2 (K), D13.1 (A)
unnamed: C50.1, C57.2, D13.3 (COM)
unnamed: C57.1, D14.3 (COM), R64.2
unnamed: IC10.2 (REF), R61.1, R65.2
unnamed: R52.1, R54.2, U4.3 (IN-)
unnamed: R53.2, U4.1 (OUT)
unnamed: R59.2, R60.1, R62.2, U5.4 (IN+)
unnamed: C56.1, R63.2, U5.3 (IN-)
unnamed: R59.1, R63.1, R64.1, U5.1 (OUT)

Notes on the sheet:
A norma IEC 61851-1 exigem uma impedancia de linha de 1 K
All capacitors are MLCC type, 50 V min, 1.5nF is C0G (NPO), 5%; all the others are X7R, 10 %
12V to -12V Inverter
All resistors are thick film: 47 ohm and 510 ohm are 0805 (125 mW min), 5% max, preferably surge-proof, all others 0603 (100mW), 1%
Control Pilot Driver

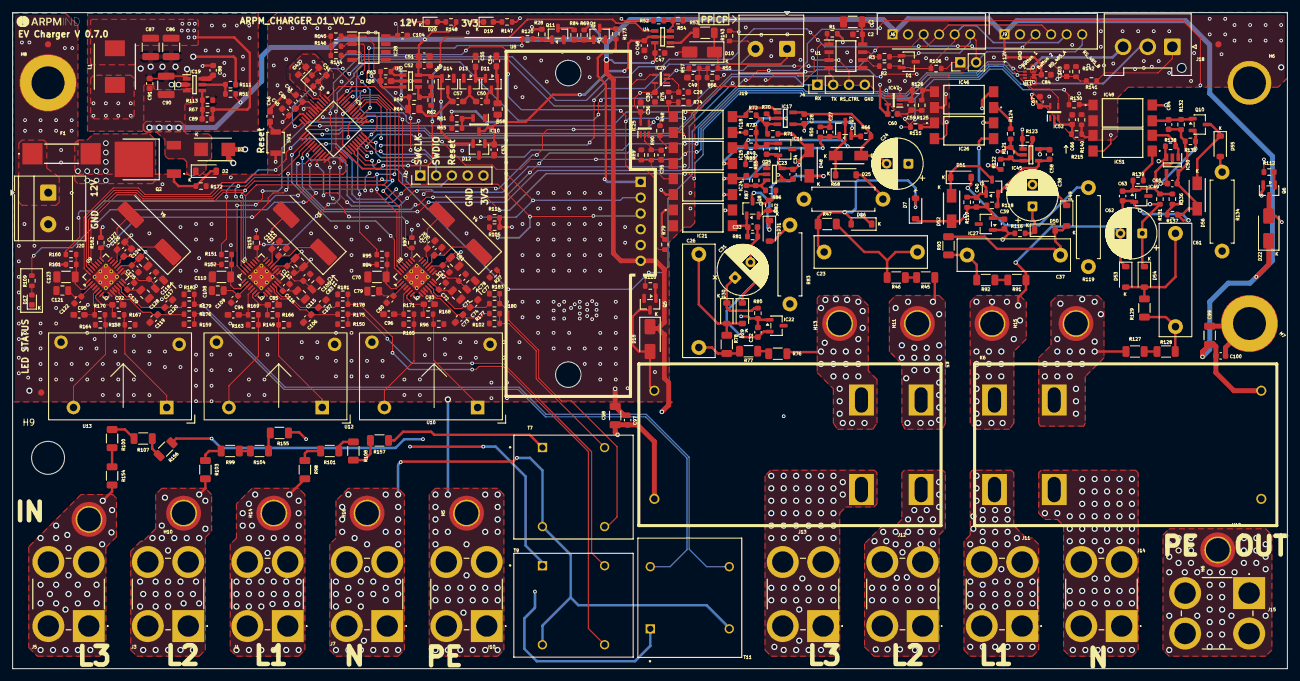
[picture p7: board Charger_Power_BOARD_V_0_7_0.kicad_pcb from above]

Board: 4 copper layers, 205.0 x 105.5 mm, 365 parts (0 on the bottom side), 210 nets.
