MarcosARPMIND/Charger_Power_BOARD_V_0_7_0/antigo/Charger_Power_BOARD_V_0_7_0_normalizado/Charger_Power_BOARD_V_0_7_0/Charger_Power_BOARD_V_0_7_0.kicad_sch

## KiCad design antigo/Charger_Power_BOARD_V_0_7_0_normalizado/Charger_Power_BOARD_V_0_7_0/Charger_Power_BOARD_V_0_7_0.kicad_sch (2026-11-06)

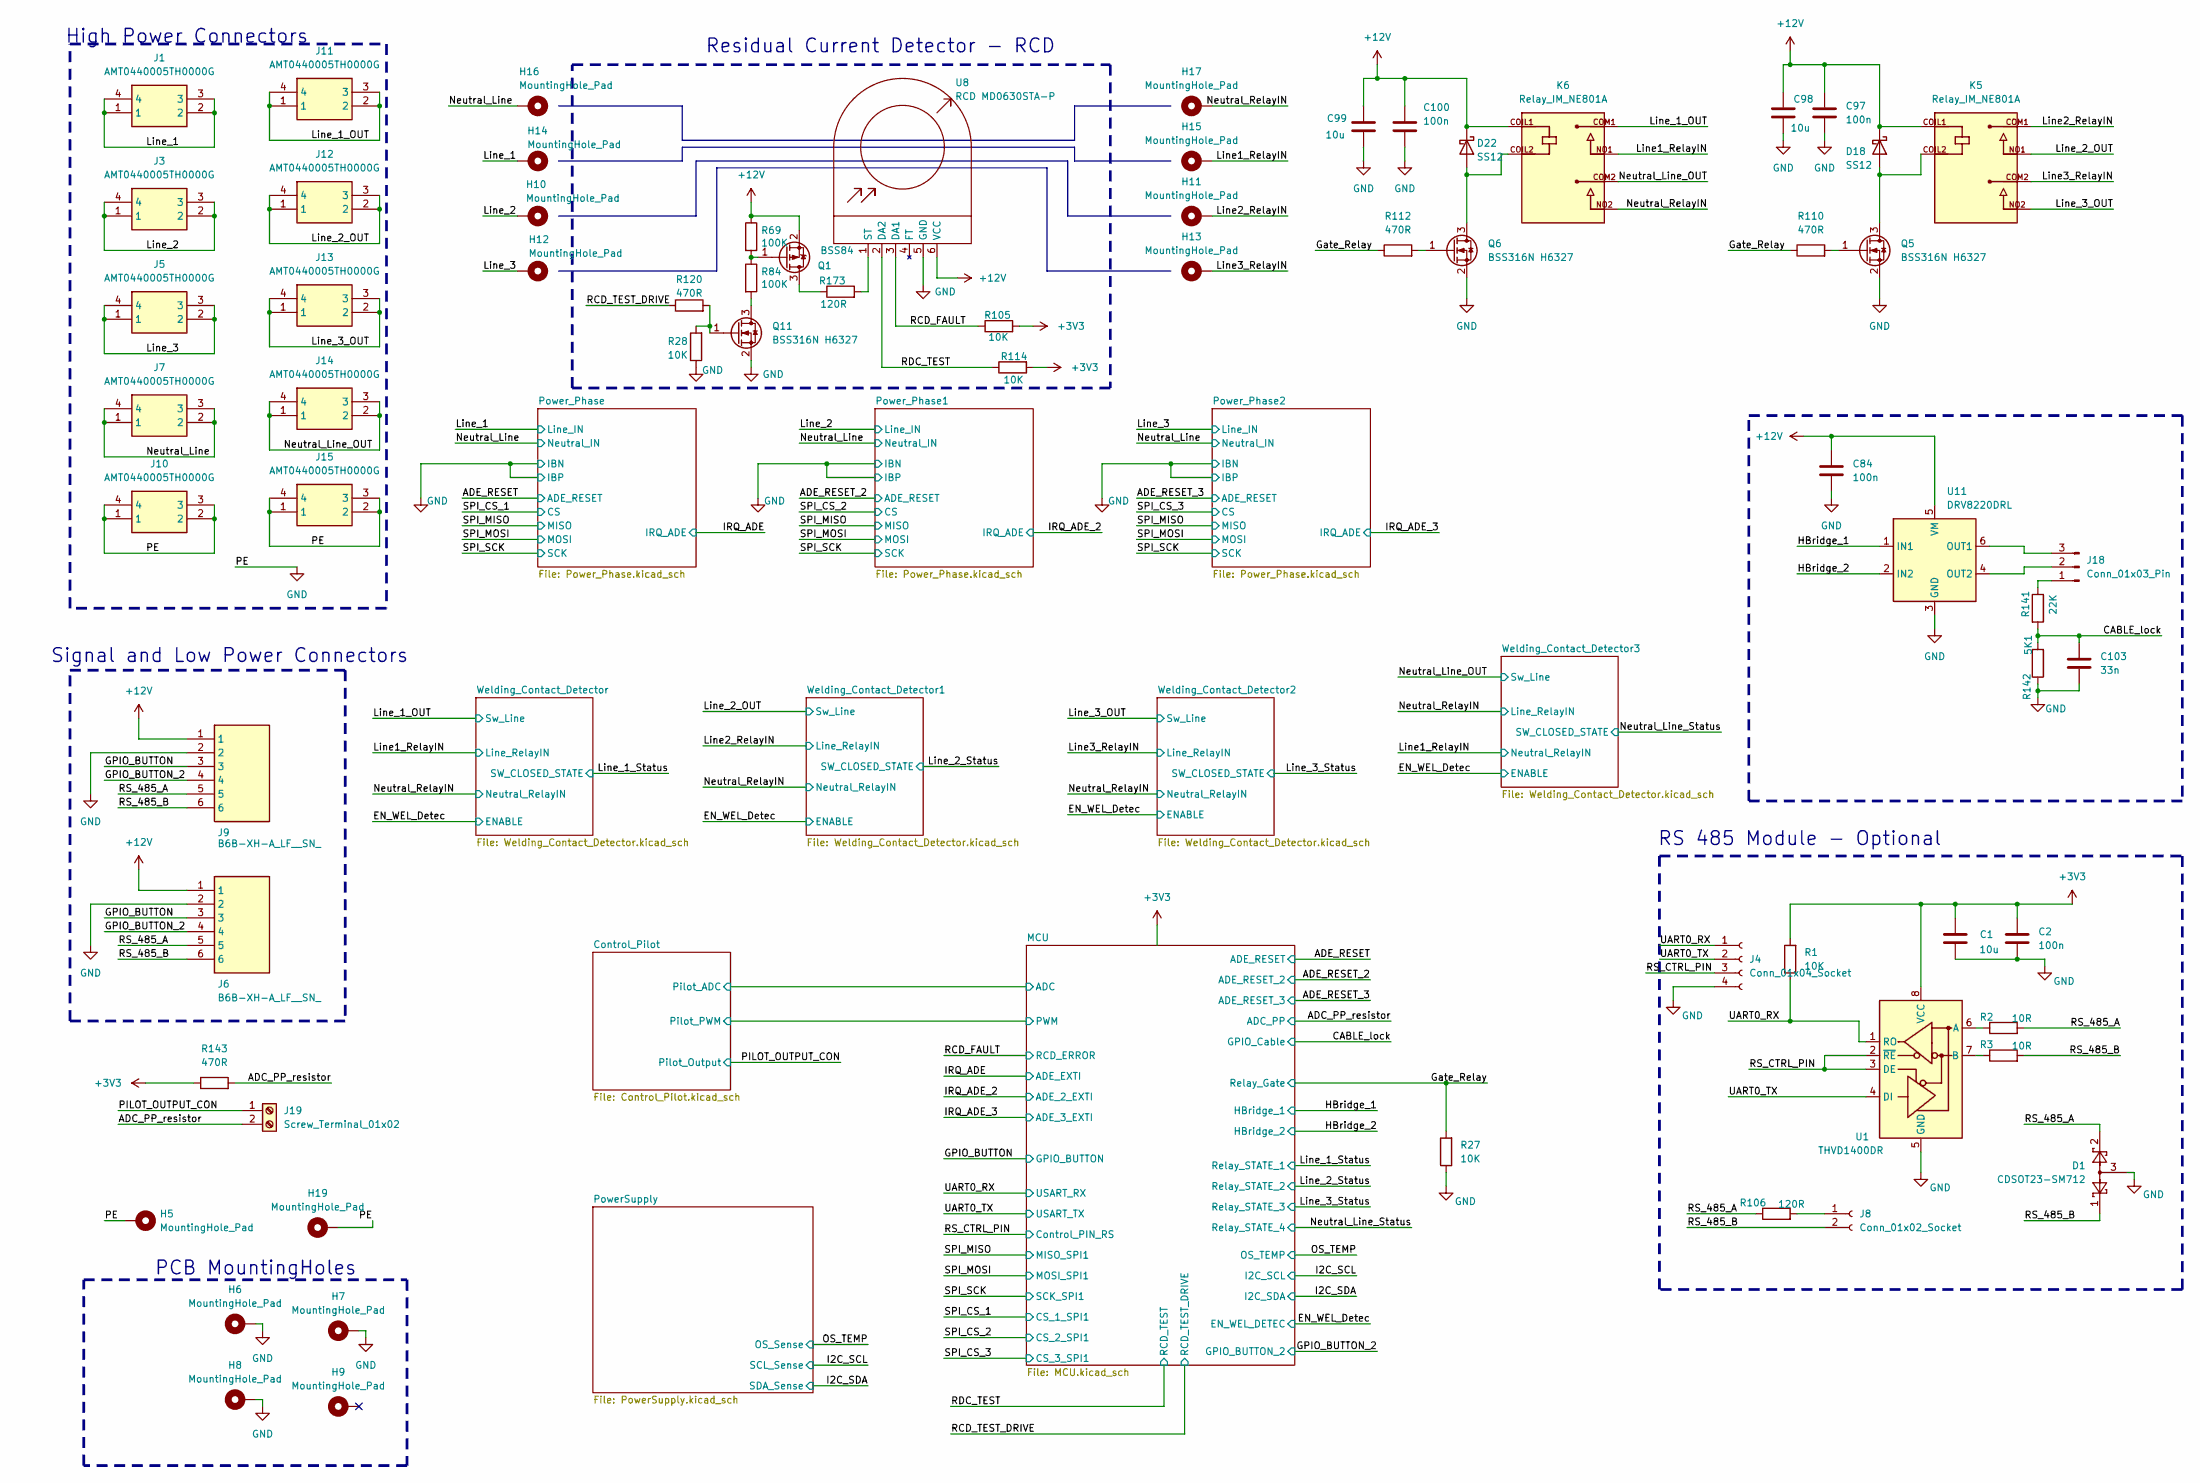
[picture p8: schematic Charger_Power_BOARD_V_0_7_0.kicad_sch]

Parts:
C1, C98, C99: 10u; C_1206_3216Metric; MPN GMK316AB7106KL-TR
C2, C84, C97, C100: 100n; C_0603_1608Metric; MPN CL10B104MB8NNNC
C103: 33n; C_0603_1608Metric
D1: CDSOT23-SM712; SOT-23-3; MPN CDSOT23-SM712
D18, D22: SS12; D_SMA; MPN SS12-E3/61T
H5, H10, H11, H12, H13, H14, H15, H16, H17, H19: MountingHole_Pad; MountingHole_3.2mm_M3_DIN965_Pad_TopBottom
H6, H7, H8: MountingHole_Pad; MountingHole_5.3mm_M5_DIN965_Pad_TopBottom
H9: MountingHole_Pad; MountingHole_5.3mm_M5
J1, J3, J5, J7, J10, J11, J12, J13, J14, J15: AMT0440005TH0000G
J4: Conn_01x04_Socket; PinHeader_1x04_P2.54mm_Vertical
J6, J9: B6B-XH-A_LF__SN_; SHDR6W64P0X250_1X6_1740X575X700P
J8: Conn_01x02_Socket; PinHeader_1x02_P2.54mm_Vertical
J18: Conn_01x03_Pin; JST_VH_B3P-VH-FB-B_1x03_P3.96mm_Vertical
J19: Screw_Terminal_01x02; TerminalBlock_Phoenix_MKDS-3-2-5.08_1x02_P5.08mm_Horizontal
K5, K6: Relay_IM_NE801A
Q1: BSS84; SOT-23
Q5, Q6, Q11: BSS316N H6327; SOT-23; MPN BSS316N H6327
R1, R27, R28, R105, R114: 10K; R_0603_1608Metric; MPN RCS060310K0FKEA
R2, R3: 10R; R_0603_1608Metric; MPN 0603WAF100JT1E
R69, R84: 100K; R_0603_1608Metric
R106: 120R; R_0603_1608Metric; MPN CRCW0603120RFKEAC
R110, R112, R120, R143: 470R; R_0603_1608Metric
R141: 22K; R_0603_1608Metric
R142: 5K1; R_0603_1608Metric
R173: 120R; R_0603_1608Metric; MPN RE0603FRE07150RL
U1: THVD1400DR; SOIC127P600X175-8N
U8: RCD MD0630STA-P; RCD_MD0630STA_P
U11: DRV8220DRL; SOT-563

Connections:
+3V3: C1.2, C2.1, R1.2, R105.2, R114.2, R143.1, U1.8 (VCC)
+12V: C84.1, C97.1, C98.1, C99.1, C100.1, D18.1 (K), D22.1 (K), J6.1, J9.1, K5.COIL1, K6.COIL1, Q1.2 (S), R69.1, U8.6 (VCC), U11.5 (VM)
ADC_PP_resistor: J19.2, R143.2
CABLE_lock: C103.1, R141.2, R142.2
GND: C1.1, C2.2, C84.2, C97.2, C98.2, C99.2, C100.2, C103.2, D1.3, H5.1, H6.1, H7.1, H8.1, H19.1, J4.4, J6.2, J9.2, J10.1, J10.2, J10.3, J10.4, J15.1, J15.2, J15.3, J15.4, Q5.2 (S), Q6.2 (S), Q11.2 (S), R27.1, R28.1, R142.1, U1.5 (GND), U8.5 (GND), U11.3 (GND)
GPIO_BUTTON: J6.3, J9.3
GPIO_BUTTON_2: J6.4, J9.4
Gate_Relay: R27.2, R110.1, R112.1
HBridge_1: U11.1 (IN1)
HBridge_2: U11.2 (IN2)
Line1_RelayIN: H15.1, K6.NO1
Line2_RelayIN: H11.1, K5.COM1
Line3_RelayIN: H13.1, K5.COM2
Line_1: H14.1, J1.1, J1.2, J1.3, J1.4
Line_1_OUT: J11.1, J11.2, J11.3, J11.4, K6.COM1
Line_2: H10.1, J3.1, J3.2, J3.3, J3.4
Line_2_OUT: J12.1, J12.2, J12.3, J12.4, K5.NO1
Line_3: H12.1, J5.1, J5.2, J5.3, J5.4
Line_3_OUT: J13.1, J13.2, J13.3, J13.4, K5.NO2
unnamed: D18.2 (A), K5.COIL2, Q5.3 (D)
unnamed: D22.2 (A), K6.COIL2, Q6.3 (D)
unnamed: J8.1, R106.2
unnamed: J18.1, R141.1
unnamed: J18.2, U11.4 (OUT2)
unnamed: J18.3, U11.6 (OUT1)
unnamed: Q1.1 (G), R69.2, R84.1
unnamed: Q1.3 (D), R173.1
unnamed: Q5.1 (G), R110.2
unnamed: Q6.1 (G), R112.2
unnamed: Q11.1 (G), R28.2, R120.2
unnamed: Q11.3 (D), R84.2
unnamed: R2.1, U1.6 (A)
unnamed: R3.1, U1.7 (B)
unnamed: R173.2, U8.1 (ST)
Neutral_Line: H16.1, J7.1, J7.2, J7.3, J7.4
Neutral_Line_OUT: J14.1, J14.2, J14.3, J14.4, K6.COM2
Neutral_RelayIN: H17.1, K6.NO2
PILOT_OUTPUT_CON: J19.1
RCD_FAULT: R105.1, U8.3 (DA1)
RCD_TEST_DRIVE: R120.1
RDC_TEST: R114.1, U8.2 (DA2)
RS_485_A: D1.2, J6.5, J9.5, R2.2, R106.1
RS_485_B: D1.1, J6.6, J8.2, J9.6, R3.2
RS_CTRL_PIN: J4.3, U1.2 (~RE), U1.3 (DE)
UART0_RX: J4.1, R1.1, U1.1 (RO)
UART0_TX: J4.2, U1.4 (DI)

Notes on the sheet:
PCB MountingHoles
Residual Current Detector - RCD
RS 485 Module - Optional
Signal and Low Power Connectors
High Power Connectors
