MarcosARPMIND/Charger_Power_BOARD_V_0_7_0/antigo/Charger_Power_BOARD_V_0_7_0_normalizado/Charger_Power_BOARD_V_0_7_0/Control_Pilot.kicad_sch

## KiCad design antigo/Charger_Power_BOARD_V_0_7_0_normalizado/Charger_Power_BOARD_V_0_7_0/Control_Pilot.kicad_sch (2026-11-06)

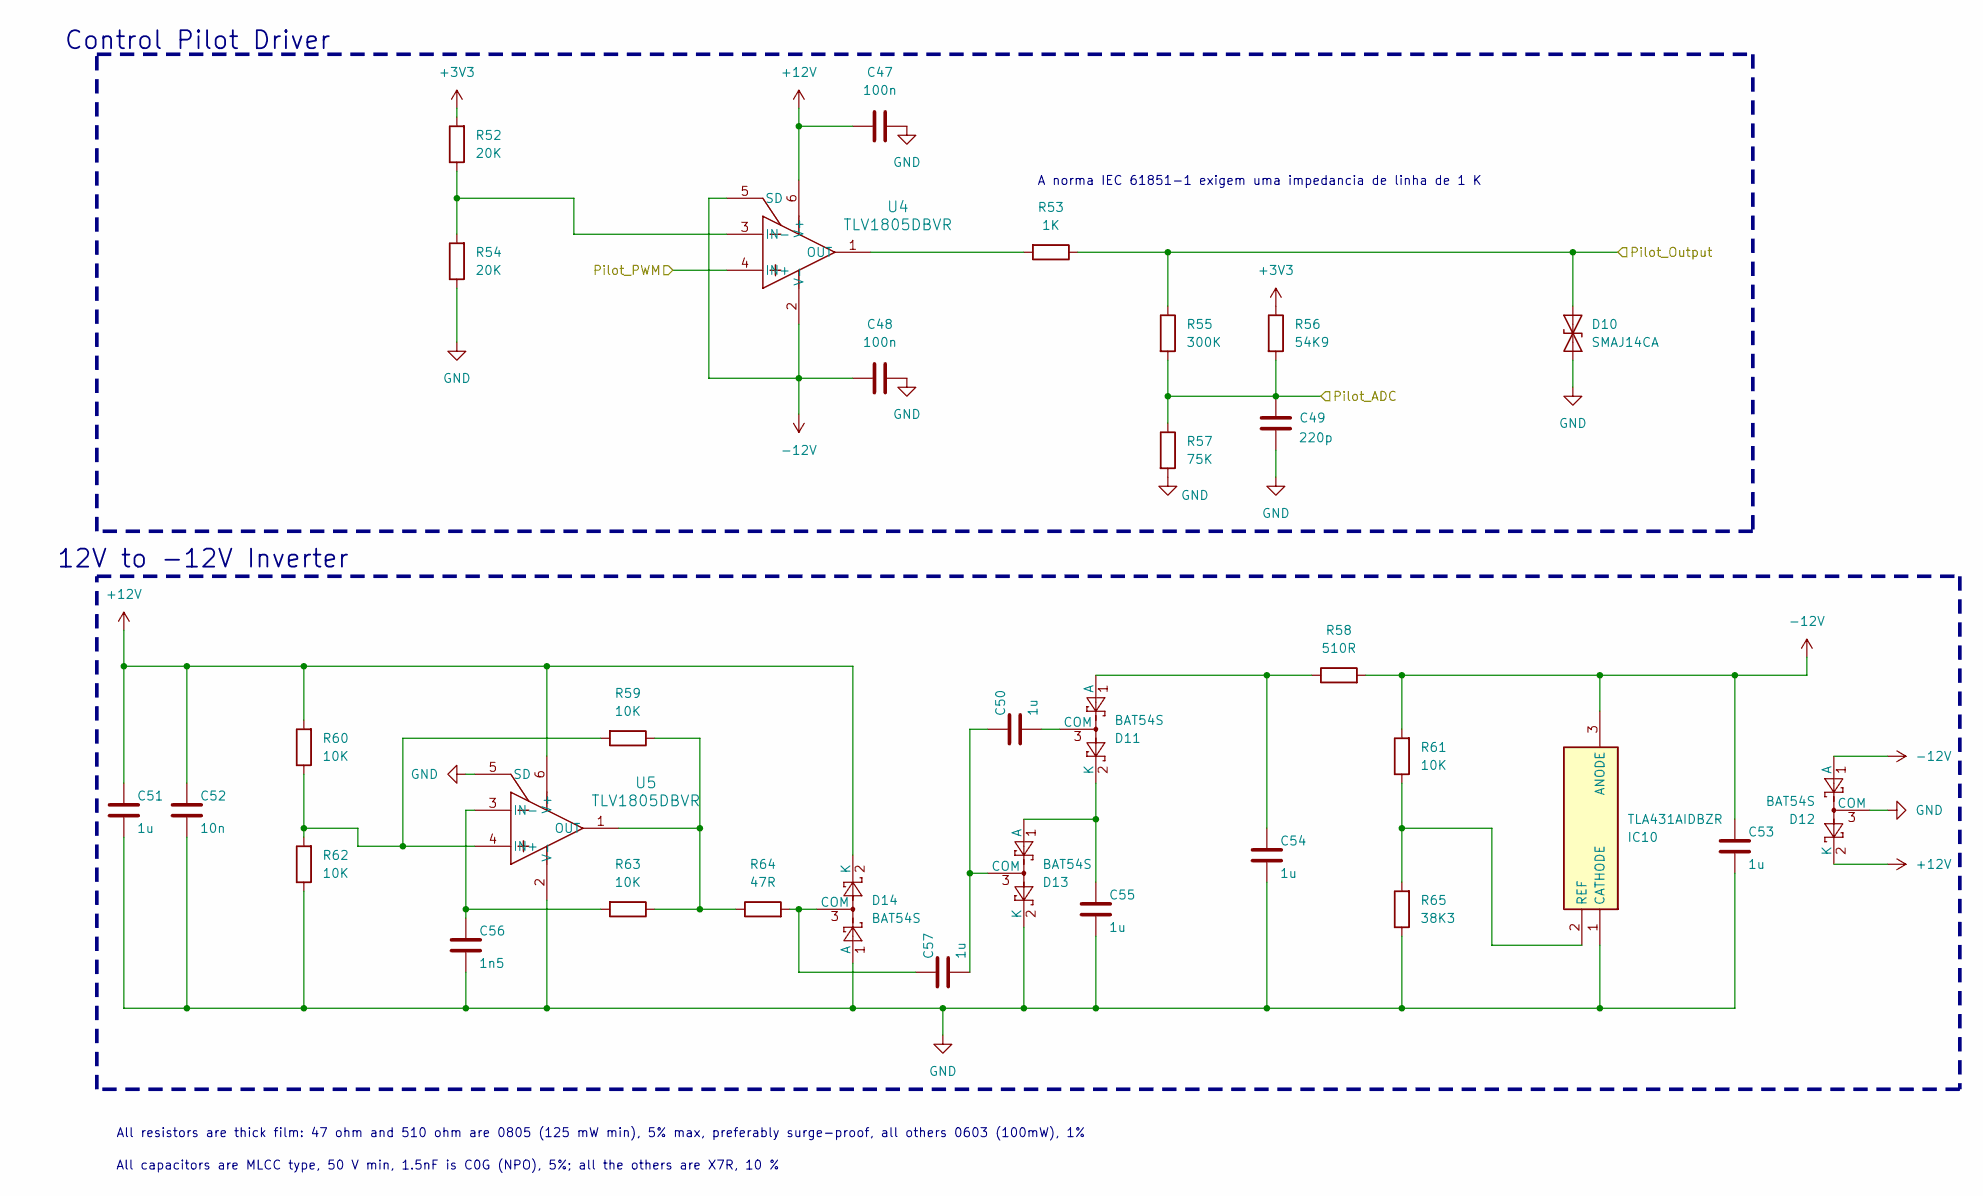
[picture p9: schematic Control_Pilot.kicad_sch]

Parts:
C47, C48: 100n; C_0603_1608Metric; MPN CL10B104MB8NNNC
C49: 220p; C_0603_1608Metric_Pad1.08x0.95mm_HandSolder; MPN CC0603JRX7R9BB221
C50, C51, C53, C54, C55, C57: 1u; C_0603_1608Metric_Pad1.08x0.95mm_HandSolder; MPN CL10B105KB8NQNC
C52: 10n; C_0603_1608Metric_Pad1.08x0.95mm_HandSolder; MPN 06035C103MAZ2A
C56: 1n5; C_0603_1608Metric_Pad1.08x0.95mm_HandSolder; MPN GCM1885C1H152JA16J
D10: SMAJ14CA; D_SMA; MPN SMAJ14CA-E3/61
D11, D12, D13, D14: BAT54S; SOT-23; MPN BAT54S-7-F
IC10: TLA431AIDBZR; SOT95P237X112-3N
R52, R54: 20K; R_0603_1608Metric; MPN CRCW060320K0FKEC
R53: 1K; R_1206_3216Metric; MPN CMP1206-FX-1001ELF
R55: 300K; R_0603_1608Metric
R56: 54K9; R_0603_1608Metric; MPN CRCW060354K9FKEA
R57: 75K; R_0603_1608Metric; MPN ERJ-PA3F7502V
R58: 510R; R_0805_2012Metric
R59, R60, R61, R62, R63: 10K; R_0603_1608Metric; MPN RCS060310K0FKEA
R64: 47R; R_0805_2012Metric; MPN CRCW080547R0JNEAC
R65: 38K3; R_0603_1608Metric; MPN CRCW060338K3FKEA
U4, U5: TLV1805DBVR; SOT95P280X145-6N; MPN TLV1805DBVR

Connections:
+3V3: R52.2, R56.1
+12V: C47.1, C51.1, C52.1, D12.2 (K), D14.2 (K), R60.2, U4.6 (V+), U5.6 (V+)
-12V: C48.1, C53.1, D12.1 (A), IC10.3 (ANODE), R58.2, R61.2, U4.2 (V-), U4.5 (SD)
GND: C47.2, C48.2, C49.1, C51.2, C52.2, C53.2, C54.2, C55.2, C56.2, D10.2 (A2), D12.3 (COM), D13.2 (K), D14.1 (A), IC10.1 (CATHODE), R54.1, R57.2, R62.1, R65.1, U5.2 (V-), U5.5 (SD)
unnamed: C50.1, C57.2, D13.3 (COM)
unnamed: C50.2, D11.3 (COM)
unnamed: C54.1, D11.1 (A), R58.1
unnamed: C55.1, D11.2 (K), D13.1 (A)
unnamed: C56.1, R63.2, U5.3 (IN-)
unnamed: C57.1, D14.3 (COM), R64.2
unnamed: IC10.2 (REF), R61.1, R65.2
unnamed: R52.1, R54.2, U4.3 (IN-)
unnamed: R53.2, U4.1 (OUT)
unnamed: R59.1, R63.1, R64.1, U5.1 (OUT)
unnamed: R59.2, R60.1, R62.2, U5.4 (IN+)
Pilot_ADC: C49.2, R55.2, R56.2, R57.1
Pilot_Output: D10.1 (A1), R53.1, R55.1
Pilot_PWM: U4.4 (IN+)

Notes on the sheet:
A norma IEC 61851-1 exigem uma impedancia de linha de 1 K
All capacitors are MLCC type, 50 V min, 1.5nF is C0G (NPO), 5%; all the others are X7R, 10 %
12V to -12V Inverter
All resistors are thick film: 47 ohm and 510 ohm are 0805 (125 mW min), 5% max, preferably surge-proof, all others 0603 (100mW), 1%
Control Pilot Driver
