MarcosARPMIND/Charger_Power_BOARD_V_0_7_0/antigo/Charger_Power_BOARD_V_0_7_0_normalizado/Charger_Power_BOARD_V_0_7_0/MCU.kicad_sch

## KiCad design antigo/Charger_Power_BOARD_V_0_7_0_normalizado/Charger_Power_BOARD_V_0_7_0/MCU.kicad_sch (2026-11-06)

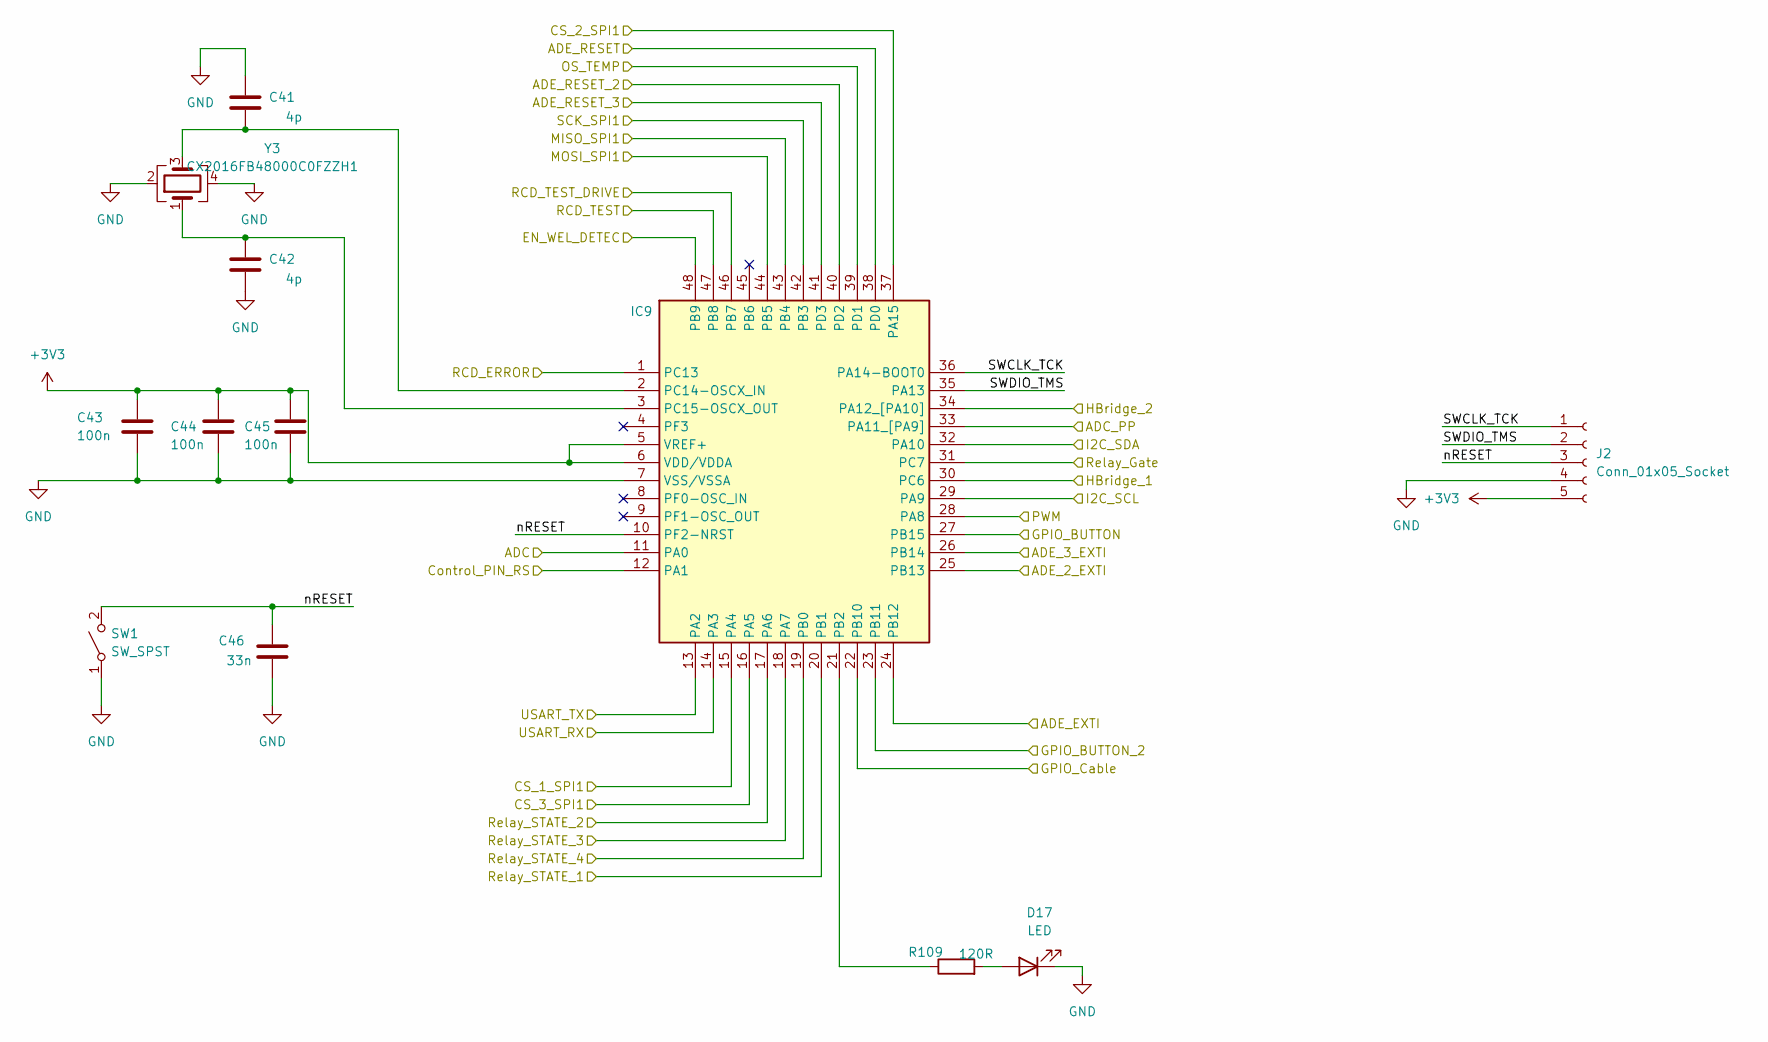
[picture p10: schematic MCU.kicad_sch]

Parts:
C41, C42: 4p; C_0603_1608Metric_Pad1.08x0.95mm_HandSolder; MPN CC0603BRNPO9BN4R0
C43, C44, C45: 100n; C_0603_1608Metric; MPN CL10B104MB8NNNC
C46: 33n; C_0603_1608Metric_Pad1.08x0.95mm_HandSolder; MPN 0603B333J500CT
D17: LED; LED_0603_1608Metric
IC9: STM32C031C6T6; QFP50P900X900X160-48N; MPN STM32C031C6T6
J2: Conn_01x05_Socket; PinHeader_1x05_P2.54mm_Vertical
R109: 120R; R_0603_1608Metric; MPN RE0603FRE07150RL
SW1: SW_SPST; SW_SPST_B3U-1000P; MPN B3U-1000PM
Y3: CX2016FB48000C0FZZH1; Crystal_SMD_2016-4Pin_2.0x1.6mm; MPN CX2016FB48000C0FZZH1

Connections:
+3V3: C43.1, C44.1, C45.1, IC9.5 (VREF+), IC9.6 (VDD/VDDA), J2.5
ADC: IC9.11 (PA0)
ADC_PP: IC9.33 (PA11_[PA9])
ADE_2_EXTI: IC9.25 (PB13)
ADE_3_EXTI: IC9.26 (PB14)
ADE_EXTI: IC9.24 (PB12)
ADE_RESET: IC9.38 (PD0)
ADE_RESET_2: IC9.40 (PD2)
ADE_RESET_3: IC9.41 (PD3)
CS_1_SPI1: IC9.15 (PA4)
CS_2_SPI1: IC9.37 (PA15)
CS_3_SPI1: IC9.16 (PA5)
Control_PIN_RS: IC9.12 (PA1)
EN_WEL_DETEC: IC9.48 (PB9)
GND: C41.2, C42.1, C43.2, C44.2, C45.2, C46.1, D17.1 (K), IC9.7 (VSS/VSSA), J2.4, SW1.1 (A), Y3.2, Y3.4
GPIO_BUTTON: IC9.27 (PB15)
GPIO_BUTTON_2: IC9.23 (PB11)
GPIO_Cable: IC9.22 (PB10)
HBridge_1: IC9.30 (PC6)
HBridge_2: IC9.34 (PA12_[PA10])
I2C_SCL: IC9.29 (PA9)
I2C_SDA: IC9.32 (PA10)
MISO_SPI1: IC9.43 (PB4)
MOSI_SPI1: IC9.44 (PB5)
unnamed: C41.1, IC9.2 (PC14-OSCX_IN), Y3.3
unnamed: C42.2, IC9.3 (PC15-OSCX_OUT), Y3.1
unnamed: D17.2 (A), R109.2
unnamed: IC9.21 (PB2), R109.1
OS_TEMP: IC9.39 (PD1)
PWM: IC9.28 (PA8)
RCD_ERROR: IC9.1 (PC13)
RCD_TEST: IC9.47 (PB8)
RCD_TEST_DRIVE: IC9.46 (PB7)
Relay_Gate: IC9.31 (PC7)
Relay_STATE_1: IC9.20 (PB1)
Relay_STATE_2: IC9.17 (PA6)
Relay_STATE_3: IC9.18 (PA7)
Relay_STATE_4: IC9.19 (PB0)
SCK_SPI1: IC9.42 (PB3)
SWCLK_TCK: IC9.36 (PA14-BOOT0), J2.1
SWDIO_TMS: IC9.35 (PA13), J2.2
USART_RX: IC9.14 (PA3)
USART_TX: IC9.13 (PA2)
nRESET: C46.2, IC9.10 (PF2-NRST), J2.3, SW1.2 (B)
