MarcosARPMIND/Charger_Power_BOARD_V_0_7_0/antigo/Charger_Power_BOARD_V_0_7_0_normalizado/Charger_Power_BOARD_V_0_7_0/PowerSupply.kicad_sch

## KiCad design antigo/Charger_Power_BOARD_V_0_7_0_normalizado/Charger_Power_BOARD_V_0_7_0/PowerSupply.kicad_sch (2026-11-06)

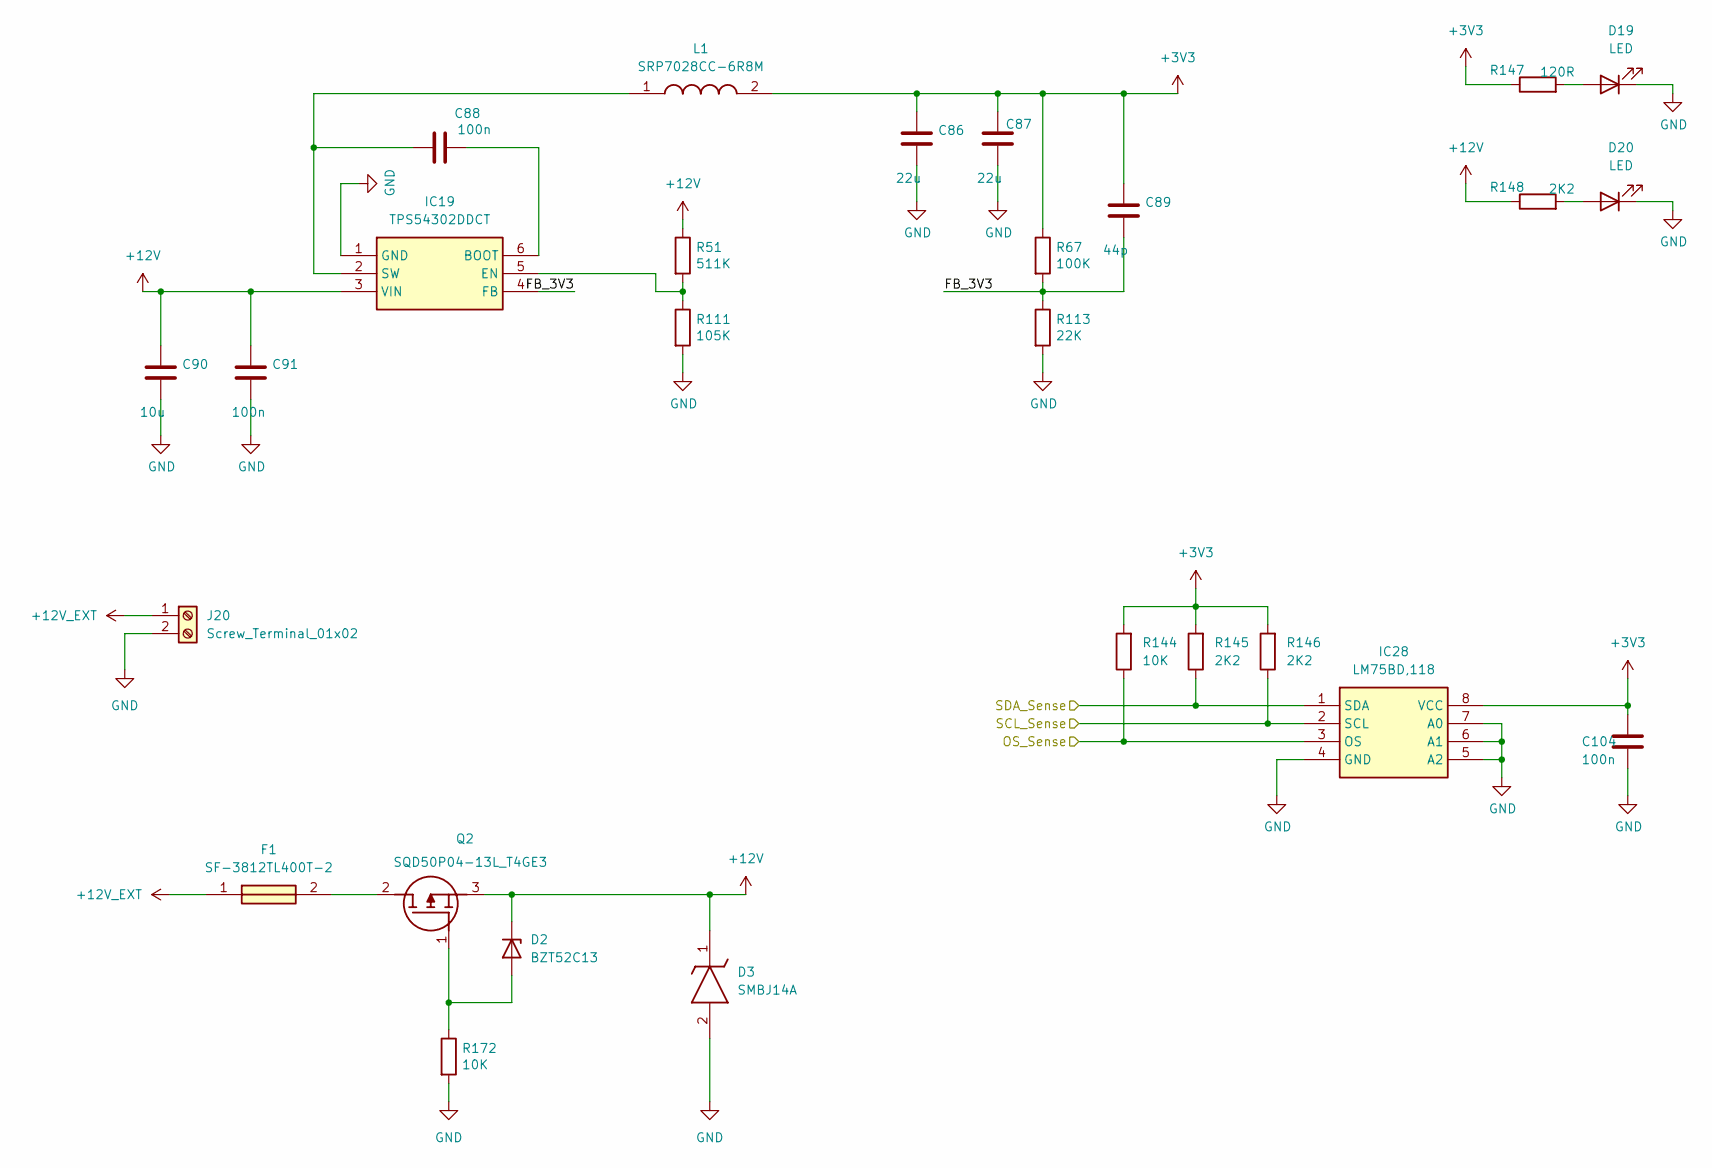
[picture p11: schematic PowerSupply.kicad_sch]

Parts:
C86, C87: 22u; C_1206_3216Metric
C88, C91, C104: 100n; C_0603_1608Metric; MPN CL10B104MB8NNNC
C89: 44p; C_0603_1608Metric
C90: 10u; C_1206_3216Metric; MPN GMK316AB7106KL-TR
D2: BZT52C13; D_SOD-123
D3: SMBJ14A; DIOM5436X261N; MPN SMBJ14A
D19, D20: LED; LED_0603_1608Metric
F1: SF-3812TL400T-2; SF3812TL400T2; MPN SF-3812TL400T-2
IC19: TPS54302DDCT; SOT95P280X110-6N
IC28: LM75BD,118; SOIC127P600X175-8N
J20: Screw_Terminal_01x02; TerminalBlock_Phoenix_MKDS-3-2-5.08_1x02_P5.08mm_Horizontal
L1: SRP7028CC-6R8M; INDPM7366X300N
Q2: SQD50P04-13L_T4GE3; SQD50P0413L_T4GE3; MPN SQD50P04-13L_T4GE3
R51: 511K; R_0603_1608Metric
R67: 100K; R_0603_1608Metric
R111: 105K; R_0603_1608Metric
R113: 22K; R_0603_1608Metric
R144, R172: 10K; R_0603_1608Metric; MPN RCS060310K0FKEA
R145, R146: 2K2; R_0603_1608Metric; MPN RCS060310K0FKEA
R147: 120R; R_0603_1608Metric; MPN CRCW0603120RFKEAC
R148: 2K2; R_0603_1608Metric; MPN AC0603FR-072K2L

Connections:
+3V3: C86.1, C87.1, C89.1, C104.1, IC28.8 (VCC), L1.2, R67.1, R144.2, R145.2, R146.2, R147.1
+12V: C90.1, C91.1, D2.1 (K), D3.1 (K), IC19.3 (VIN), Q2.3 (S), R51.1, R148.1
+12V_EXT: F1.1, J20.1
FB_3V3: C89.2, IC19.4 (FB), R67.2, R113.1
GND: C86.2, C87.2, C90.2, C91.2, C104.2, D3.2 (A), D19.1 (K), D20.1 (K), IC19.1 (GND), IC28.4 (GND), IC28.5 (A2), IC28.6 (A1), IC28.7 (A0), J20.2, R111.2, R113.2, R172.2
unnamed: C88.1, IC19.2 (SW), L1.1
unnamed: C88.2, IC19.6 (BOOT)
unnamed: D2.2 (A), Q2.1 (G), R172.1
unnamed: D19.2 (A), R147.2
unnamed: D20.2 (A), R148.2
unnamed: F1.2, Q2.2 (D)
unnamed: IC19.5 (EN), R51.2, R111.1
OS_Sense: IC28.3 (OS), R144.1
SCL_Sense: IC28.2 (SCL), R146.1
SDA_Sense: IC28.1 (SDA), R145.1
