MarcosARPMIND/Charger_Power_BOARD_V_0_7_0/antigo/Charger_Power_BOARD_V_0_7_0_normalizado/Charger_Power_BOARD_V_0_7_0/Power_Phase.kicad_sch

## KiCad design antigo/Charger_Power_BOARD_V_0_7_0_normalizado/Charger_Power_BOARD_V_0_7_0/Power_Phase.kicad_sch (2026-11-06)

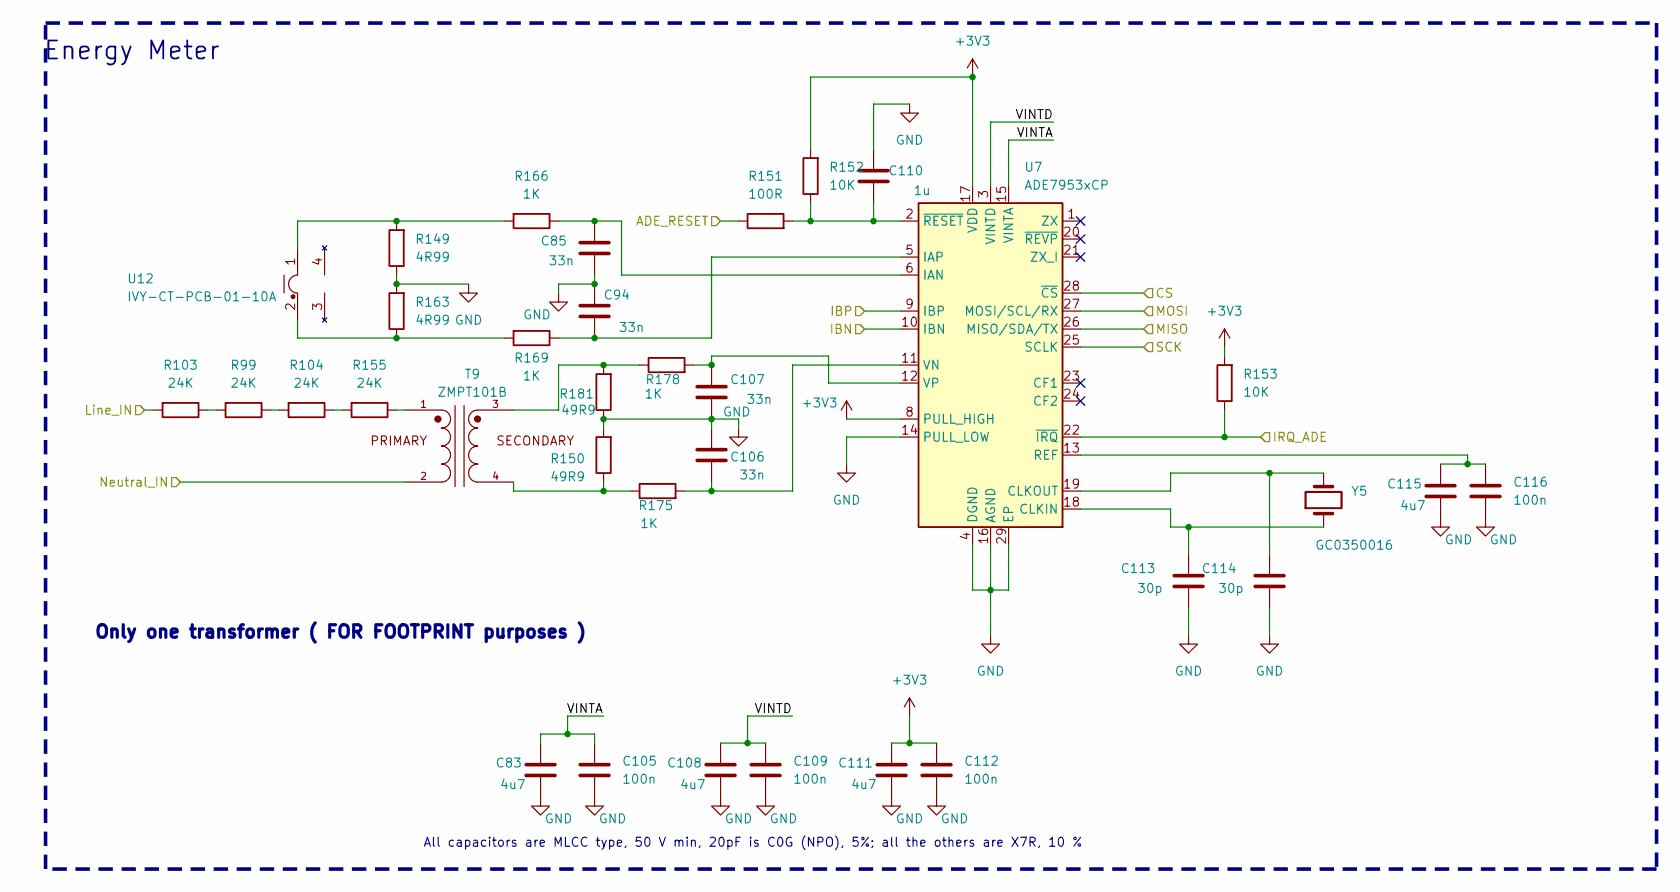
[picture p12: schematic Power_Phase.kicad_sch]

Parts:
C83, C108, C111, C115: 4u7; C_0805_2012Metric; MPN GRM21BZ7YA475ME15L
C85, C94, C106, C107: 33n; C_0603_1608Metric_Pad1.08x0.95mm_HandSolder; MPN 0603B333J500CT
C105, C109, C112, C116: 100n; C_0603_1608Metric; MPN CL10B104MB8NNNC
C110: 1u; C_1206_3216Metric; MPN CL10B105KB8NQNC
C113, C114: 30p; C_0603_1608Metric_Pad1.08x0.95mm_HandSolder; MPN CML0603C0G300JT50V
R99, R103, R104, R155: 24K; R_1206_3216Metric; MPN ESR18EZPF2402
R149, R163: 4R99; R_0603_1608Metric; MPN CRCW06034K99FKEAC
R150, R181: 49R9; R_0603_1608Metric; MPN CRCW0603100RJNEA
R151: 100R; R_0603_1608Metric; MPN CRCW0603100RJNEA
R152, R153: 10K; R_0603_1608Metric; MPN RCS060310K0FKEA
R166, R169, R175, R178: 1K; R_0603_1608Metric; MPN CRCW060336R0FKEA
T9: ZMPT101B; XFMR_ZMPT101B
U7: ADE7953xCP; LFCSP-28-1EP_5x5mm_P0.5mm_EP3.14x3.14mm_ThermalVias_MigCOM; MPN ADE7953ACPZ
U12: IVY-CT-PCB-01-10A; CT_IVY_01_10A
Y5: GC0350016; Crystal_SMD_HC49-SD; MPN GC0350016

Connections:
+3V3: C111.2, C112.1, R152.2, R153.2, U7.7 (PULL_HIGH), U7.8 (PULL_HIGH), U7.17 (VDD)
ADE_RESET: R151.1
CS: U7.28 (~CS)
GND: C83.1, C85.1, C94.2, C105.2, C106.2, C107.1, C108.1, C109.2, C110.2, C111.1, C112.2, C113.1, C114.1, C115.1, C116.2, R149.1, R150.2, R163.2, R181.1, U7.4 (DGND), U7.14 (PULL_LOW), U7.16 (AGND), U7.29 (EP)
IBN: U7.10 (IBN)
IBP: U7.9 (IBP)
IRQ_ADE: R153.1, U7.22 (~IRQ)
Line_IN: R103.2
MISO: U7.26 (MISO/SDA/TX)
MOSI: U7.27 (MOSI/SCL/RX)
unnamed: C85.2, R166.1, U7.6 (IAN)
unnamed: C94.1, R169.1, U7.5 (IAP)
unnamed: C106.1, R175.2, U7.11 (VN)
unnamed: C107.2, R178.2, U7.12 (VP)
unnamed: C110.1, R151.2, R152.1, U7.2 (~RESET)
unnamed: C113.2, U7.18 (CLKIN), Y5.1
unnamed: C114.2, U7.19 (CLKOUT), Y5.2
unnamed: C115.2, C116.1, U7.13 (REF)
unnamed: R99.2, R103.1
unnamed: R104.1, R155.2
unnamed: R99.1, R104.2
unnamed: R149.2, R166.2, U12.1
unnamed: R150.1, R175.1, T9.4
unnamed: R155.1, T9.1
unnamed: R163.1, R169.2, U12.2
unnamed: R178.1, R181.2, T9.3
Neutral_IN: T9.2
SCK: U7.25 (SCLK)
VINTA: C83.2, C105.1, U7.15 (VINTA)
VINTD: C108.2, C109.1, U7.3 (VINTD)

Notes on the sheet:
All capacitors are MLCC type, 50 V min, 20pF is C0G (NPO), 5%; all the others are X7R, 10 %
Energy Meter
Only one transformer ( FOR FOOTPRINT purposes )
