MarcosARPMIND/Charger_Power_BOARD_V_0_7_0/antigo/Charger_Power_BOARD_V_0_7_0_normalizado/Charger_Power_BOARD_V_0_7_0/Welding_Contact_Detector.kicad_sch

## KiCad design antigo/Charger_Power_BOARD_V_0_7_0_normalizado/Charger_Power_BOARD_V_0_7_0/Welding_Contact_Detector.kicad_sch (2026-11-06)

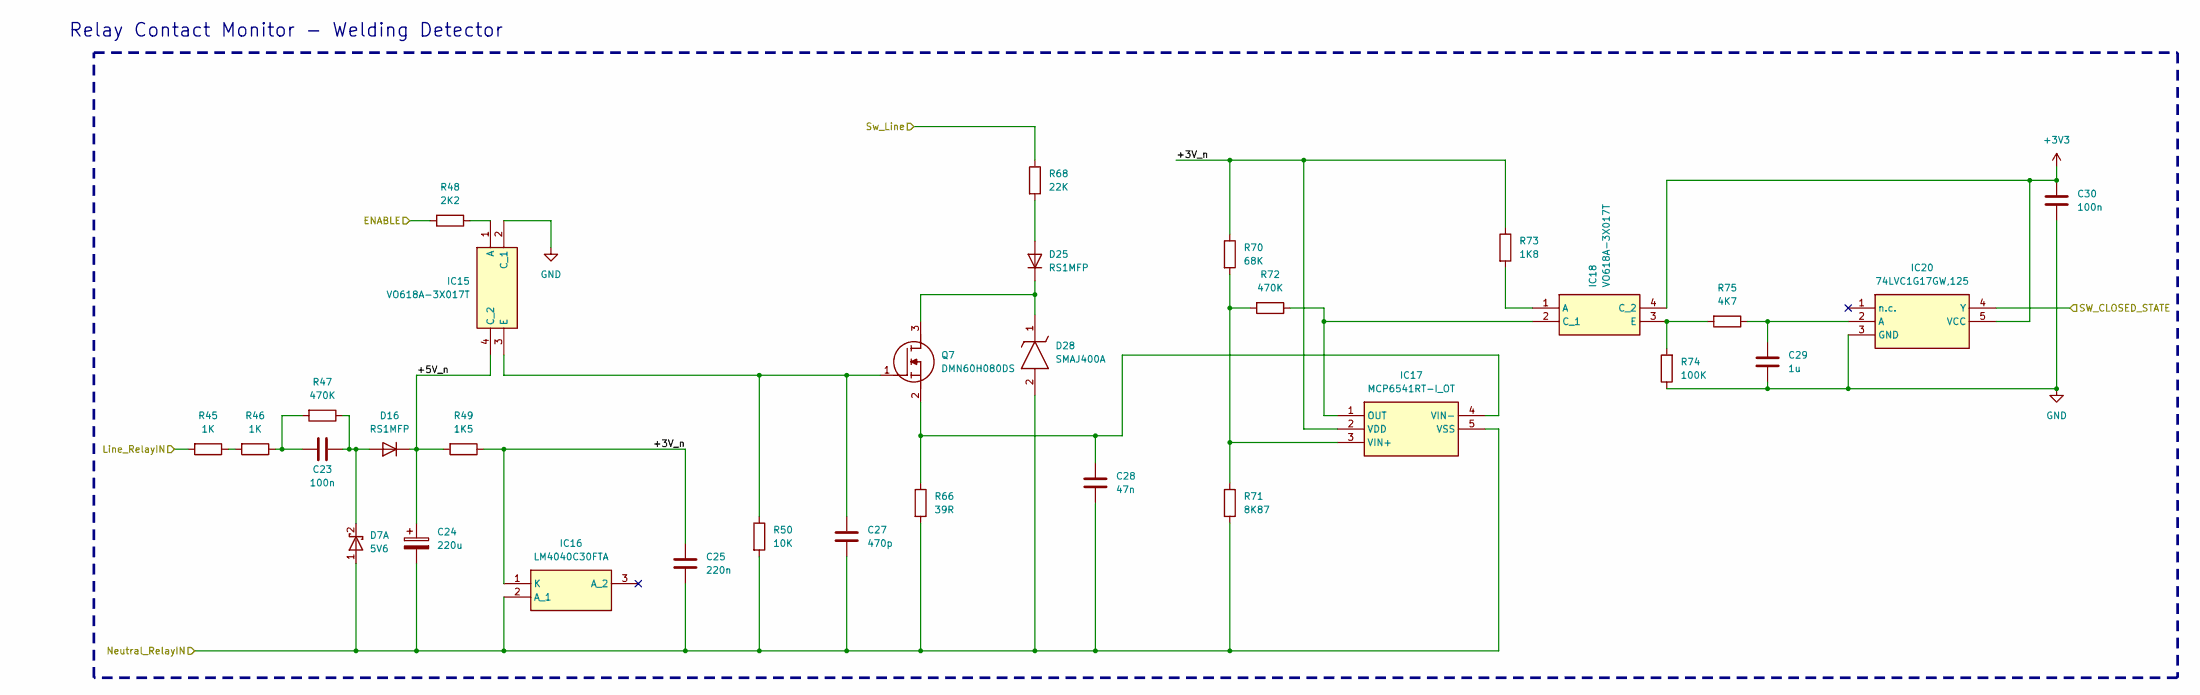
[picture p13: schematic Welding_Contact_Detector.kicad_sch]

Parts:
C23: 100n; C_Rect_L18.0mm_W5.0mm_P15.00mm_FKS3_FKP3
C24: 220u; CP_Radial_D8.0mm_P3.50mm
C25: 220n; C_0603_1608Metric
C27: 470p; C_0603_1608Metric
C28: 47n; C_0603_1608Metric
C29: 1u; C_0603_1608Metric
C30: 100n; C_0603_1608Metric; MPN CL10B104MB8NNNC
D7: 5V6; D_SOD-123
D16, D25: RS1MFP; D_SOD-123
D28: SMAJ400A; DIOM5026X229N
IC15, IC18: VO618A-3X017T; SMD-4_OPTION_7
IC16: LM4040C30FTA; SOT-23-3
IC17: MCP6541RT-I_OT; SOT95P280X145-5N
IC20: 74LVC1G17GW,125; SOT65P212X110-5N
Q7: DMN60H080DS; SOT-23-3
R45, R46: 1K; R_1206_3216Metric
R47: 470K; R_1206_3216Metric
R48: 2K2; R_0603_1608Metric; MPN AC0603FR-072K2L
R49: 1K5; R_0603_1608Metric
R50: 10K; R_0603_1608Metric; MPN RCS060310K0FKEA
R66: 39R; R_0603_1608Metric
R68: 22K; R_Axial_DIN0411_L9.9mm_D3.6mm_P12.70mm_Horizontal
R70: 68K; R_0603_1608Metric
R71: 8K87; R_0603_1608Metric
R72: 470K; R_0603_1608Metric
R73: 1K8; R_0603_1608Metric
R74: 100K; R_0603_1608Metric
R75: 4K7; R_0603_1608Metric

Connections:
+3V3: C30.1, IC18.4 (C_2), IC20.5 (VCC)
+3V_n: C25.1, IC16.1 (K), IC17.2 (VDD), R49.1, R70.1, R73.1
+5V_n: C24.1, D16.1 (K), IC15.4 (C_2), R49.2
ENABLE: R48.2
GND: C29.2, C30.2, IC15.2 (C_1), IC20.3 (GND), R74.1
Line_RelayIN: R45.2
unnamed: C23.1, D7.2 (K), D16.2 (A), R47.1
unnamed: C23.2, R46.1, R47.2
unnamed: C27.1, IC15.3 (E), Q7.1 (G), R50.1
unnamed: C28.1, IC17.4 (VIN-), Q7.2 (S), R66.1
unnamed: C29.1, IC20.2 (A), R75.1
unnamed: D25.1 (K), D28.1 (K), Q7.3 (D)
unnamed: D25.2 (A), R68.2
unnamed: IC15.1 (A), R48.1
unnamed: IC17.1 (OUT), IC18.2 (C_1), R72.1
unnamed: IC17.3 (VIN+), R70.2, R71.1, R72.2
unnamed: IC18.1 (A), R73.2
unnamed: IC18.3 (E), R74.2, R75.2
unnamed: R45.1, R46.2
Neutral_RelayIN: C24.2, C25.2, C27.2, C28.2, D7.1 (A), D28.2 (A), IC16.2 (A_1), IC17.5 (VSS), R50.2, R66.2, R71.2
SW_CLOSED_STATE: IC20.4 (Y)
Sw_Line: R68.1

Notes on the sheet:
Relay Contact Monitor - Welding Detector
