MarcosARPMIND/Charger_Power_BOARD_V_0_7_0/(commit log)

2026-09-07 Initial commit - Charger Power Board v0.7.0
    [ADE7953_IC.kicad_sch, Charger_Power_BOARD_V_0_6_0.kicad_pcb, Charger_Power_BOARD_V_0_6_0.kicad_sch, Control_Pilot.kicad_sch, MCU.kicad_sch, PowerSupply.kicad_sch, Power_Neutral.kicad_sch, Power_Phase.kicad_sch]
2026-10-09 Implementação do novo circuito do Wleding detector; correcao dos campos dos componentes
    [ADE7953_IC.kicad_sch, Charger_Power_BOARD_V_0_6_0.kicad_pcb, Charger_Power_BOARD_V_0_7_0.kicad_pcb, Charger_Power_BOARD_V_0_7_0.kicad_sch, Control_Pilot.kicad_sch, MCU.kicad_sch, PowerSupply.kicad_sch, Power_Neutral.kicad_sch]
2026-10-09 continuação do layout
    [Charger_Power_BOARD_V_0_7_0.kicad_pcb]
2026-10-16 Routing terminado; A corrigir violações; falta colocar as proteçãoes de inversão de polaridade; fusivél; TVS
    [Charger_Power_BOARD_V_0_6_0.kicad_pcb, Charger_Power_BOARD_V_0_6_0.kicad_sch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]
2026-10-16 pequena correção
    [Charger_Power_BOARD_V_0_7_0.kicad_sch]
2026-10-20 Layout finalizado
    [Charger_Power_BOARD_V_0_7_0-B_Cu.gbr, Charger_Power_BOARD_V_0_7_0-B_Fab.gbr, Charger_Power_BOARD_V_0_7_0-B_Mask.gbr, Charger_Power_BOARD_V_0_7_0-B_Paste.gbr, Charger_Power_BOARD_V_0_7_0-B_Silkscreen.gbr, Charger_Power_BOARD_V_0_7_0-Edge_Cuts.gbr, Charger_Power_BOARD_V_0_7_0-F_Courtyard.gbr, Charger_Power_BOARD_V_0_7_0-F_Cu.gbr]
2026-10-20 panelização feita, falta trocar o user_commnts para edge cuts
    [Charger_Power_BOARD_V_0_7_0.kicad_pcb, Charger_Power_BOARD_V_0_7_0_panelize.kicad_pcb]
2026-11-06 correções no condesadores do conversor DCDC
    [Charger_Power_BOARD_V_0_7_0.kicad_pcb, Charger_Power_BOARD_V_0_7_0.kicad_sch, Charger_Power_BOARD_V_0_7_0_frame.kicad_pcb, Charger_Power_BOARD_V_0_7_0_p.kicad_pcb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]
